machunyu/HC8001/DataSheet/TFT/KD024B_3C/截图1485099521.png

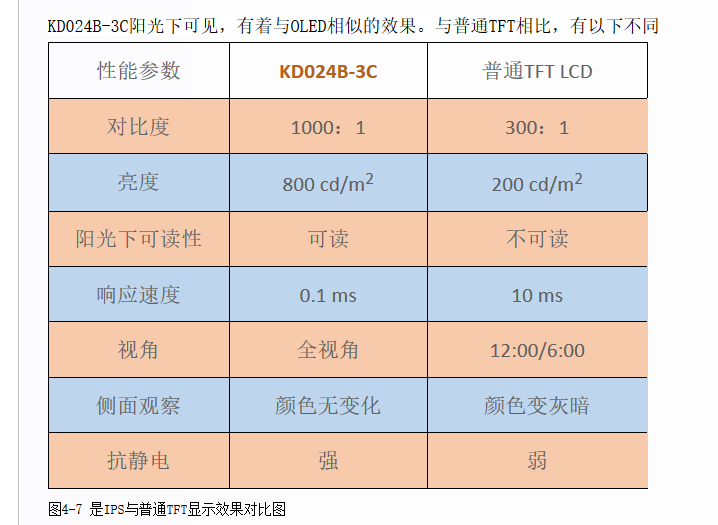
DataSheet/TFT/KD024B_3C/截图1485099521.png
