machunyu/HC8001/Sch/芯片验证板原理图.pdf

5

4

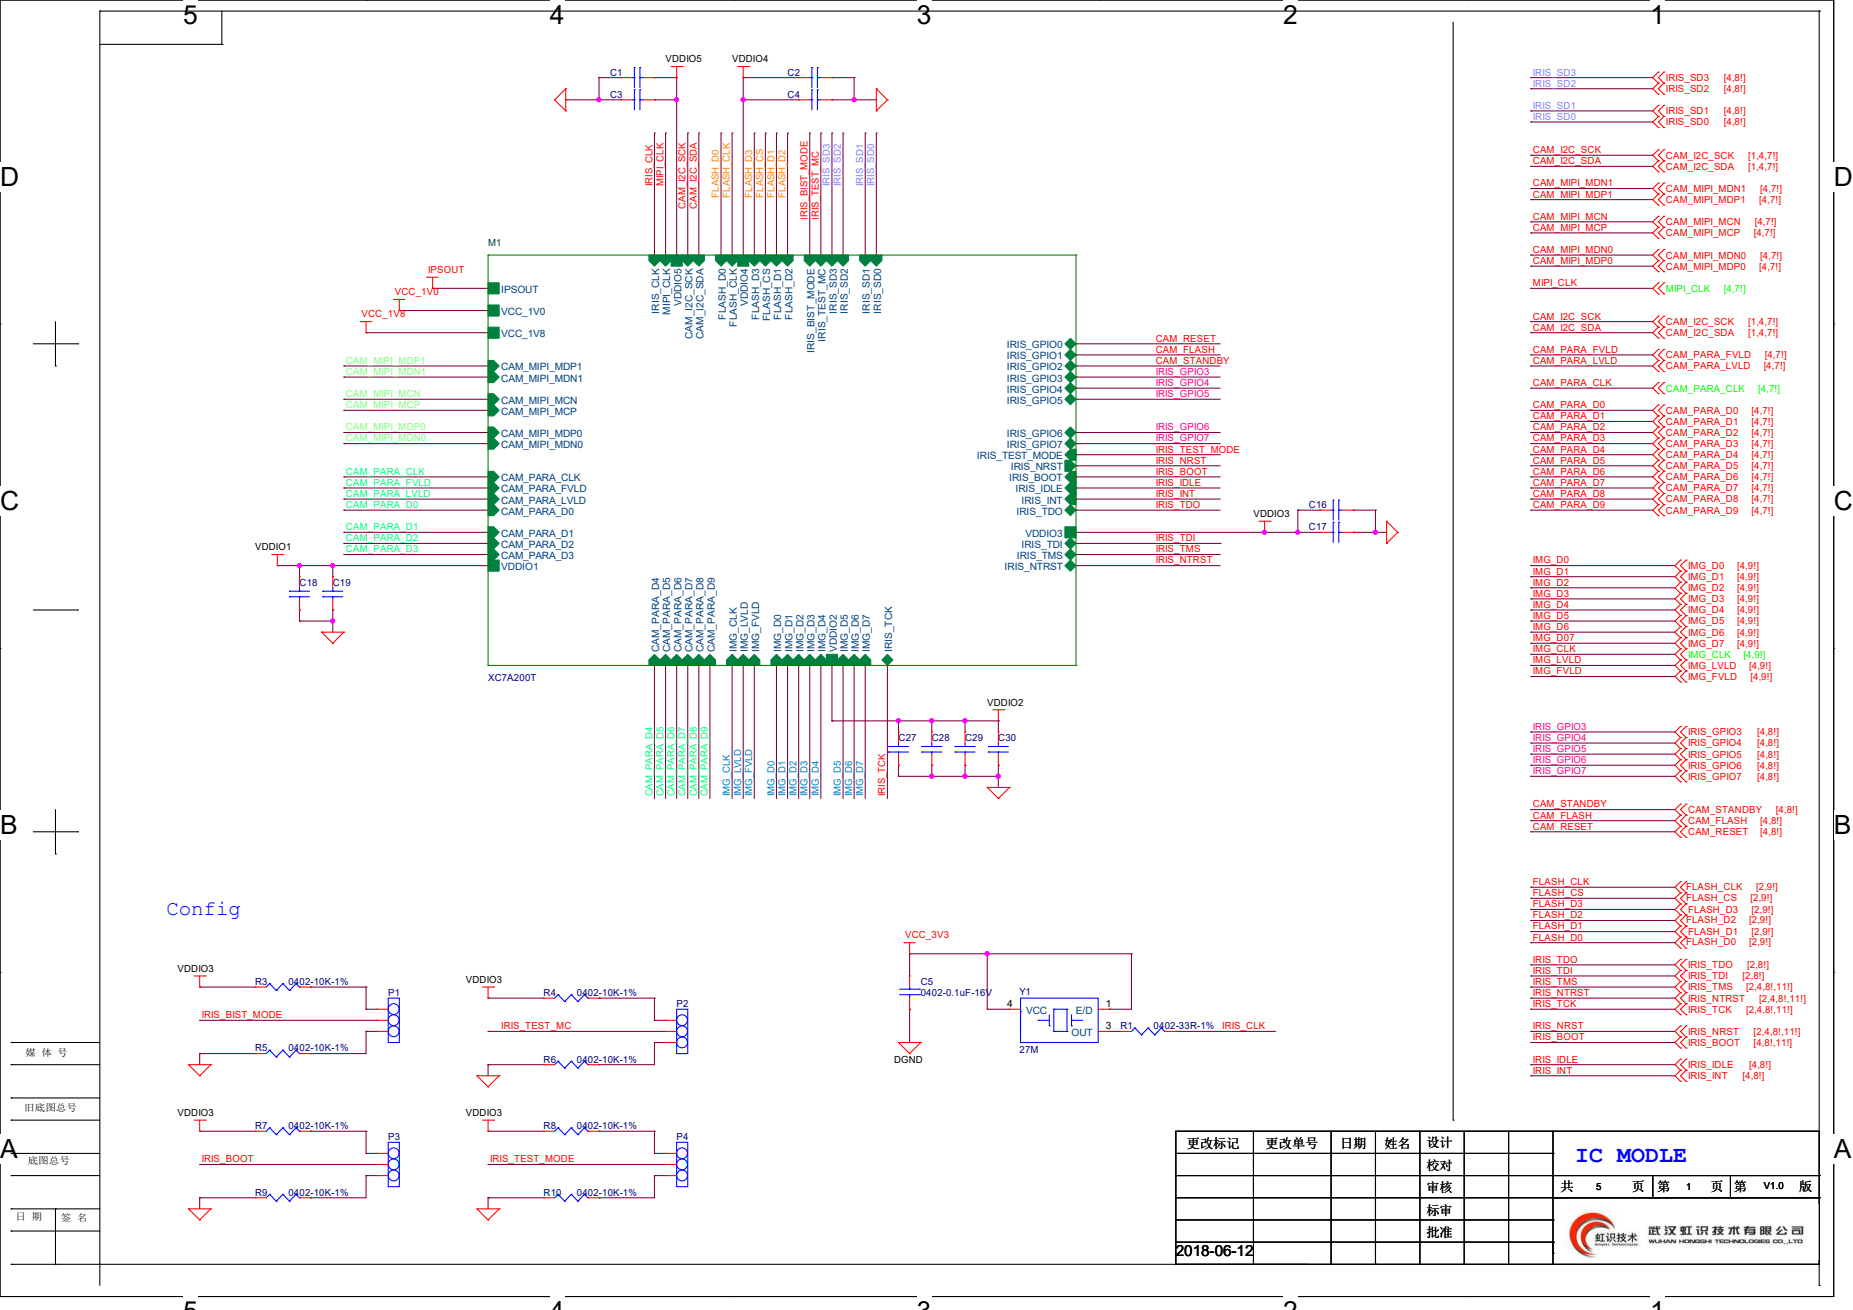
[picture p40: page 1]

D D

# SPI Flash

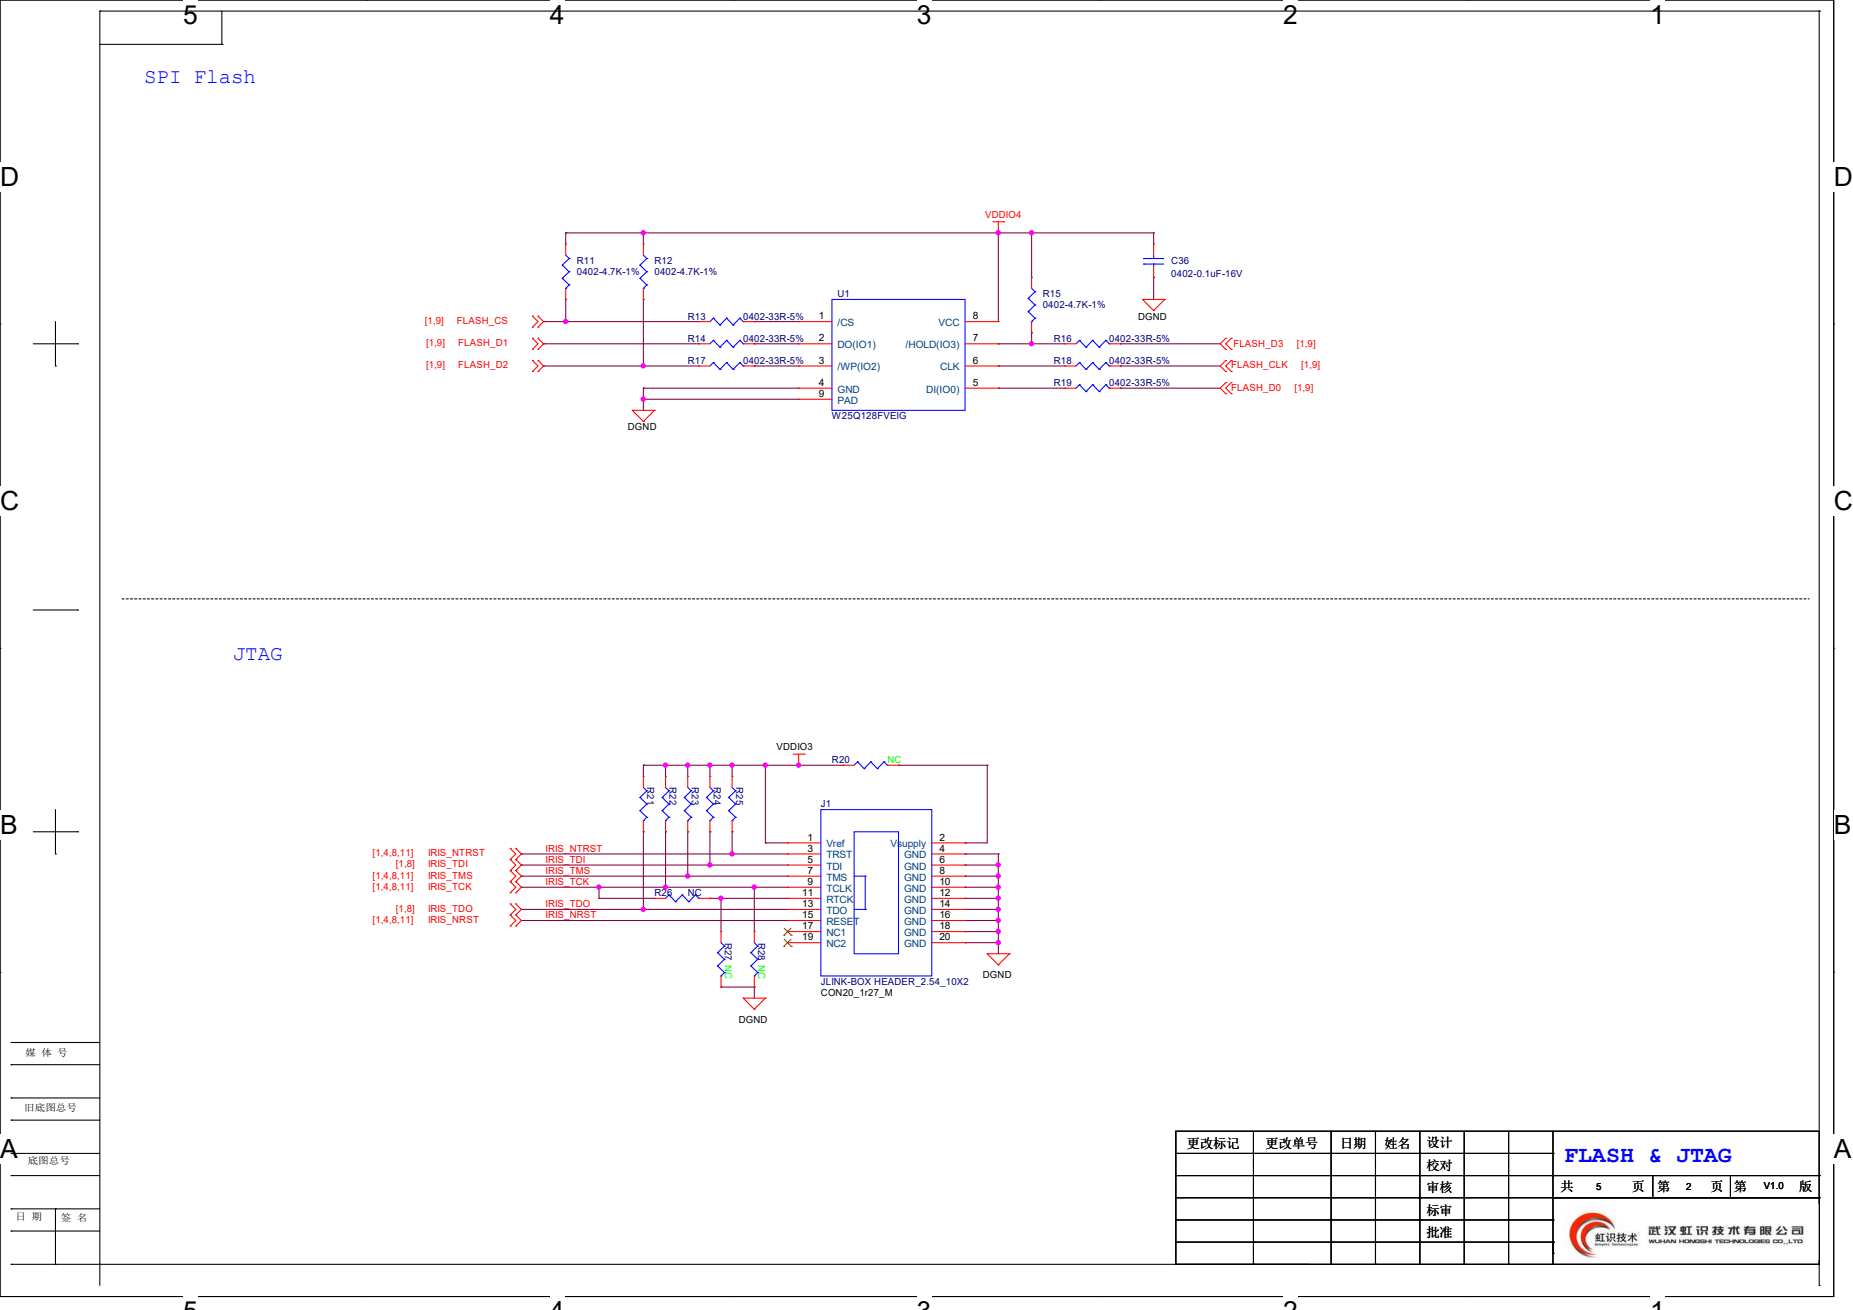
[picture p41: page 2]

D D

3V3

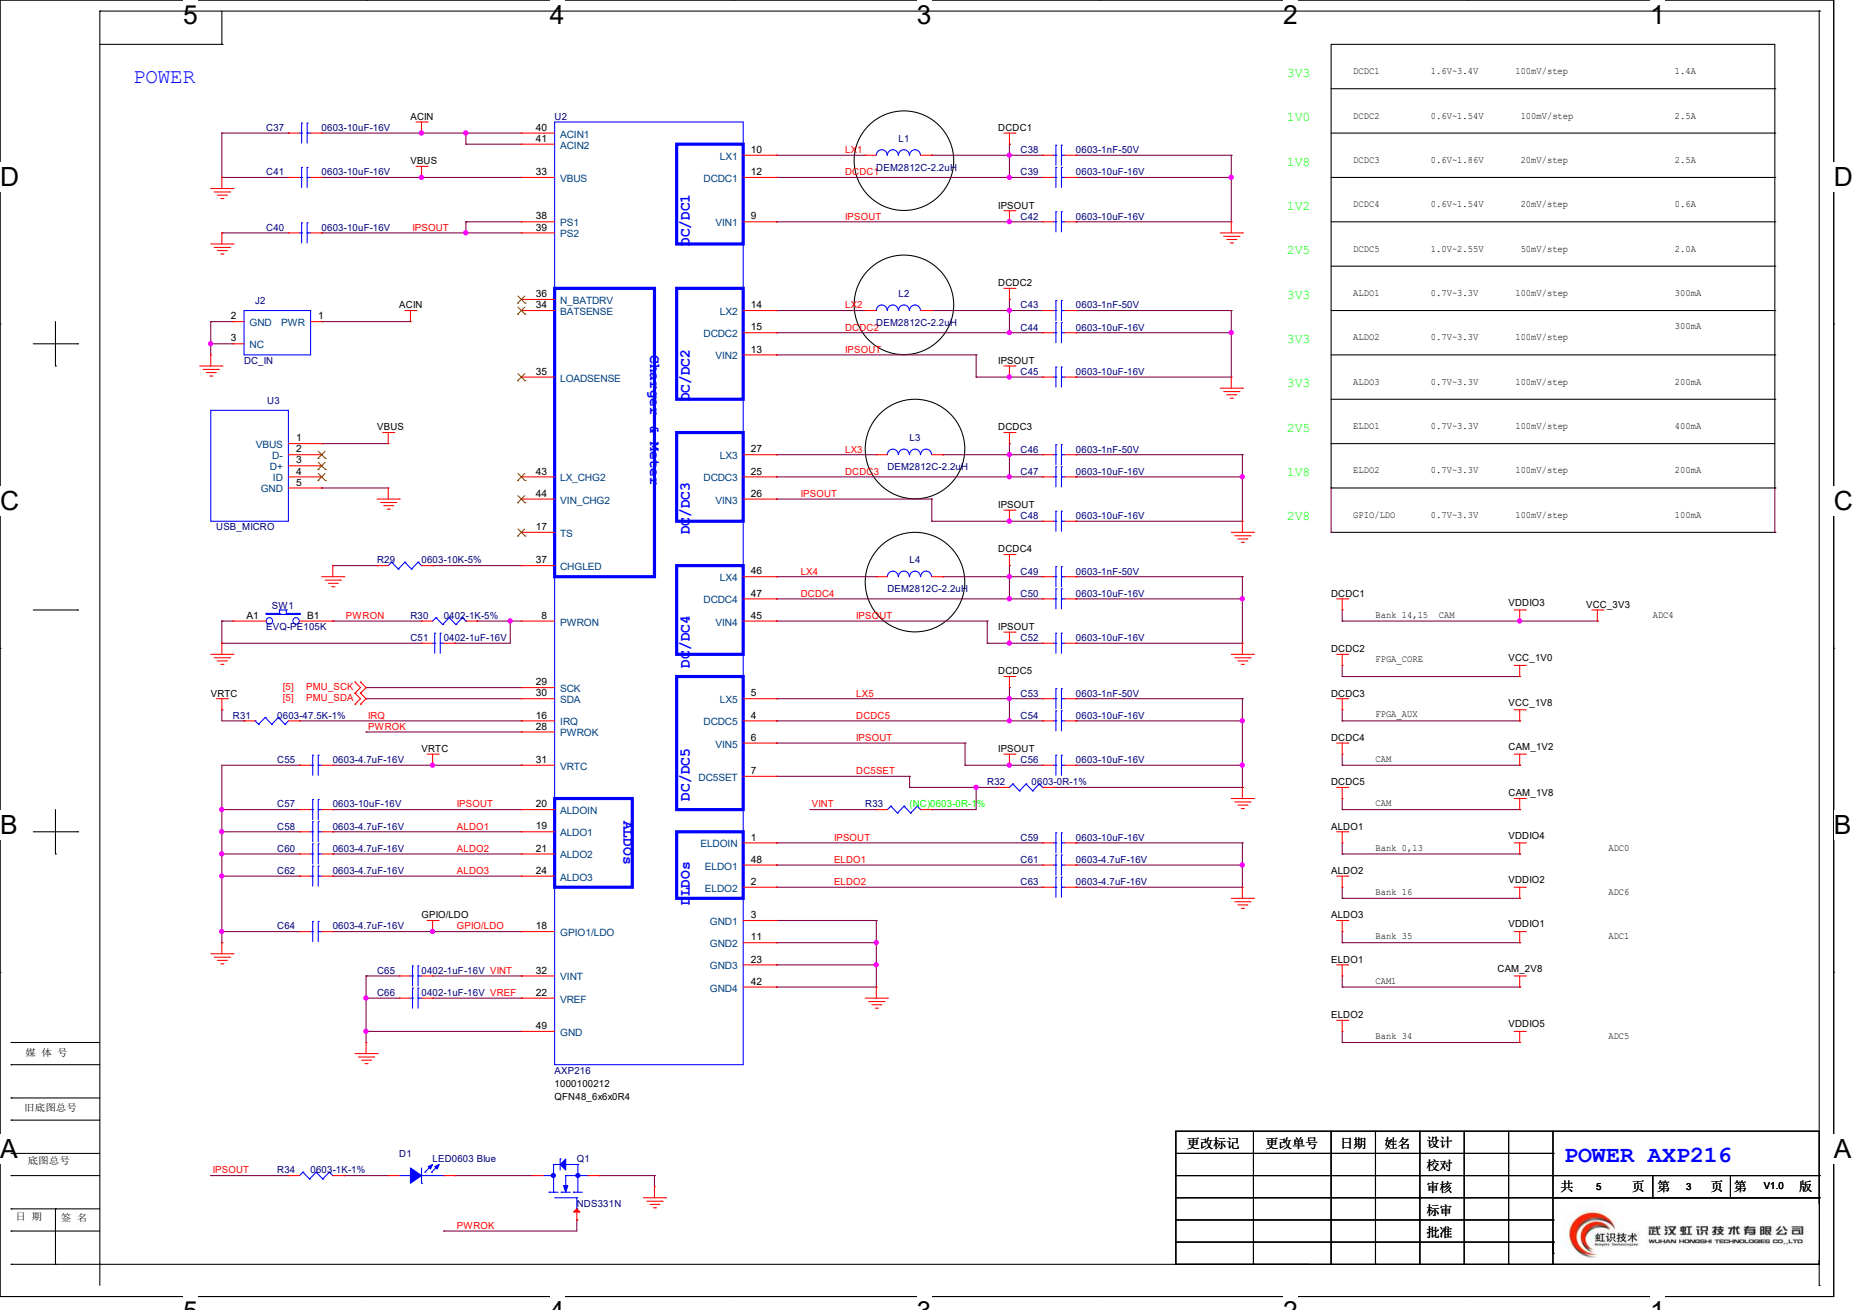
[picture p42: page 3]

L2 DEM2812C-2.2uH
LX3 27 DCDC3 25 PWRON 8 GPIO1/LDO 18 VINT 32 VRTC 31

D D

# CONNECTOR

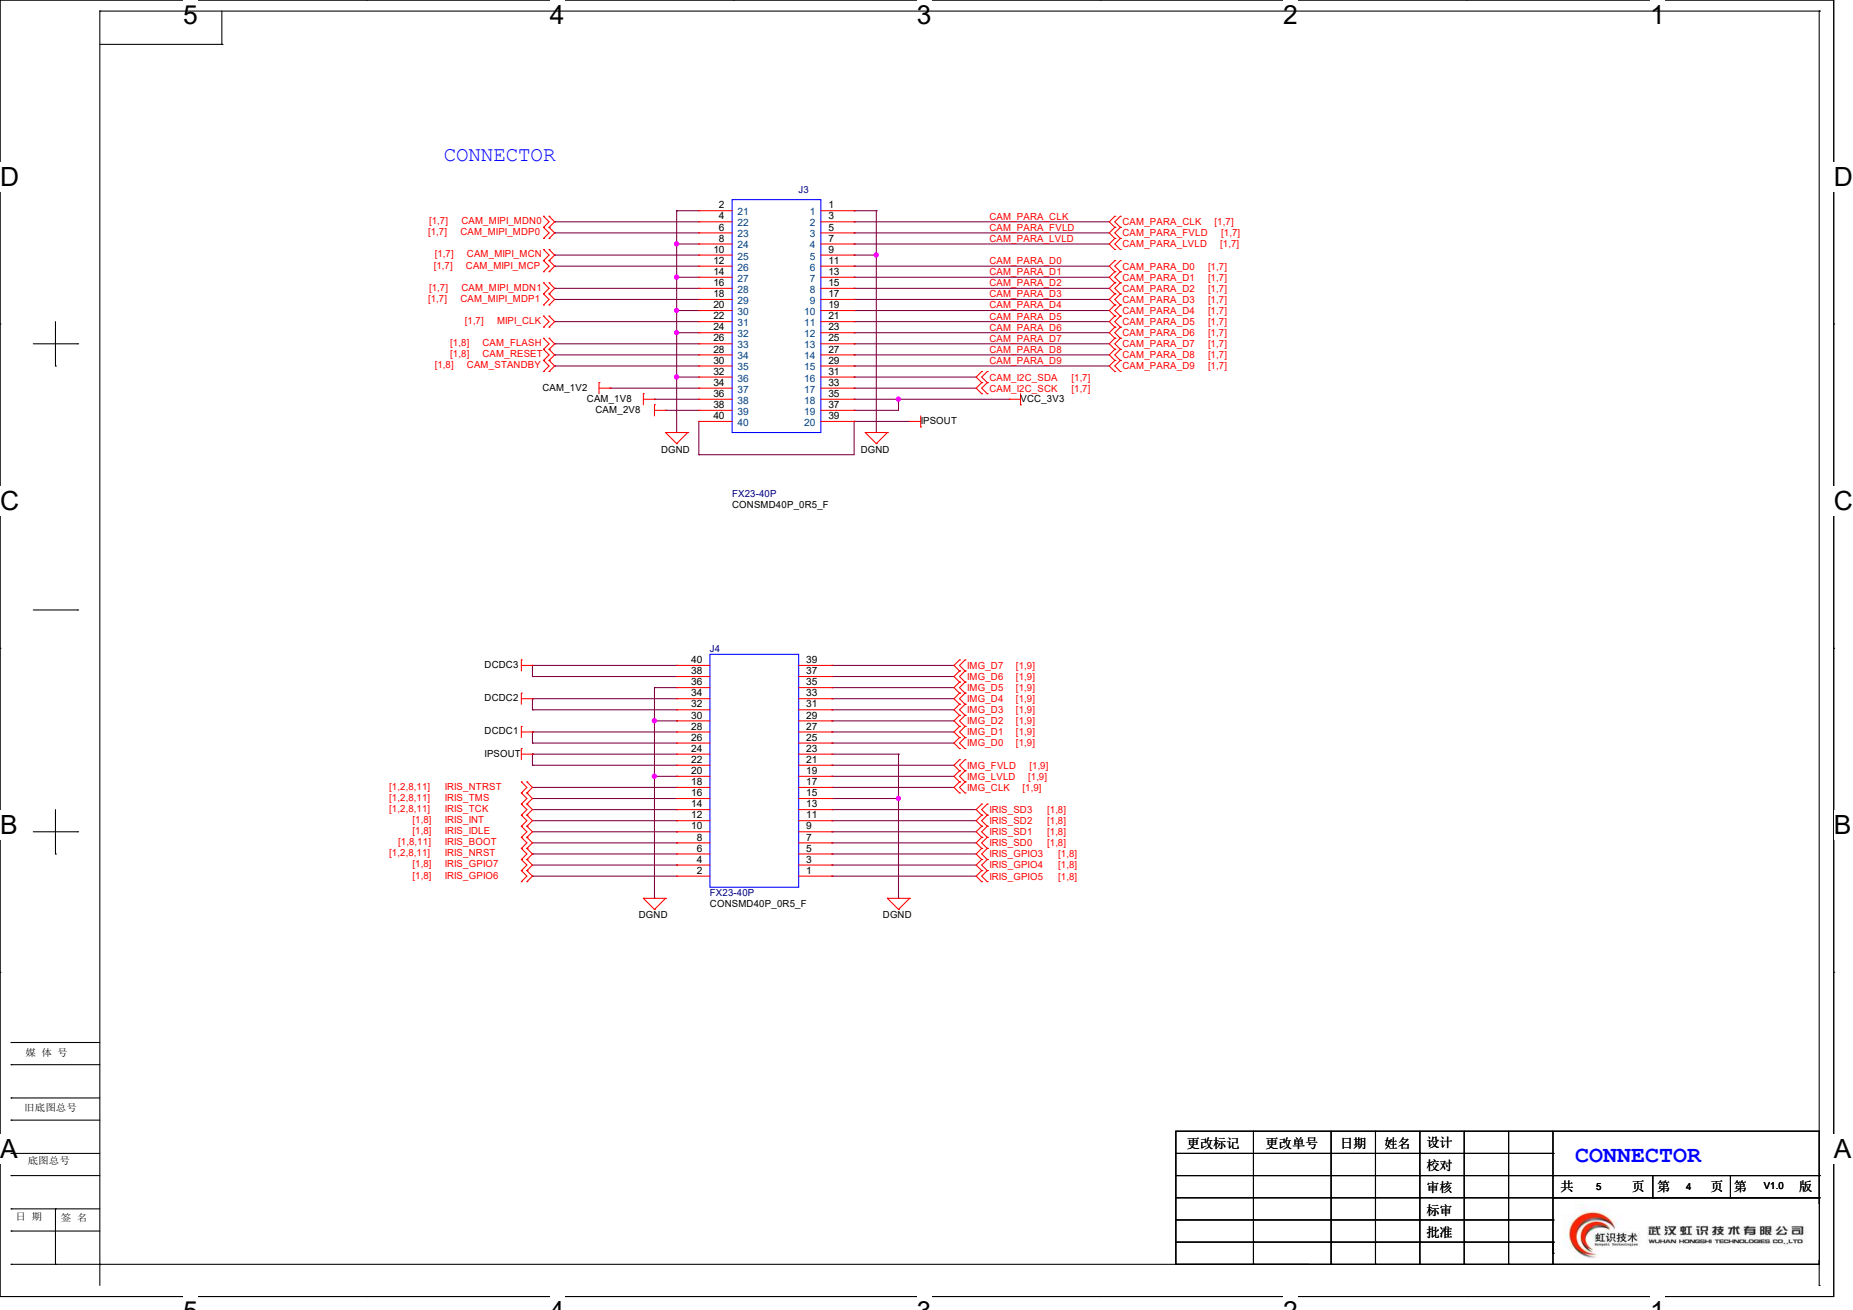
[picture p43: page 4]
底图总号; 旧底图总号; CONNECTOR; CAM_PARA_FVLD CAM_PARA_LVLD; CAM_PARA_D3 CAM_PARA_D4 CAM_PARA_D5 CAM_PARA_D6 CAM_PARA_D7 CAM_PARA_D8 CAM_PARA_D9 CAM_PARA_D1 CAM_PARA_D2 CAM_PARA_D0 CAM_PARA_CLK; DCDC3 DCDC2 DCDC1; IPSOUT; DGND; VCC_3V3 CAM_1V2CAM_1V8 CAM_2V8; CAM_PARA_D3; [1,7] CAM_PARA_D4; [1,7] CAM_PARA_D5; [1,7] CAM_PARA_D6; [1,7] CAM_PARA_D7; [1,7] CAM_PARA_D8; [1,7] CAM_PARA_D9; [1,7] CAM_PARA_LVLD; [1,7] CAM_PARA_FVLD; CAM_STANDBY; CAM_MIPI_MDN1; CAM_MIPI_MDP1; CAM_MIPI_MCP; CAM_MIPI_MCN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

D D

# MCU_LED1 MCU_LED2 MCU_LED3 ADC5 ADC6

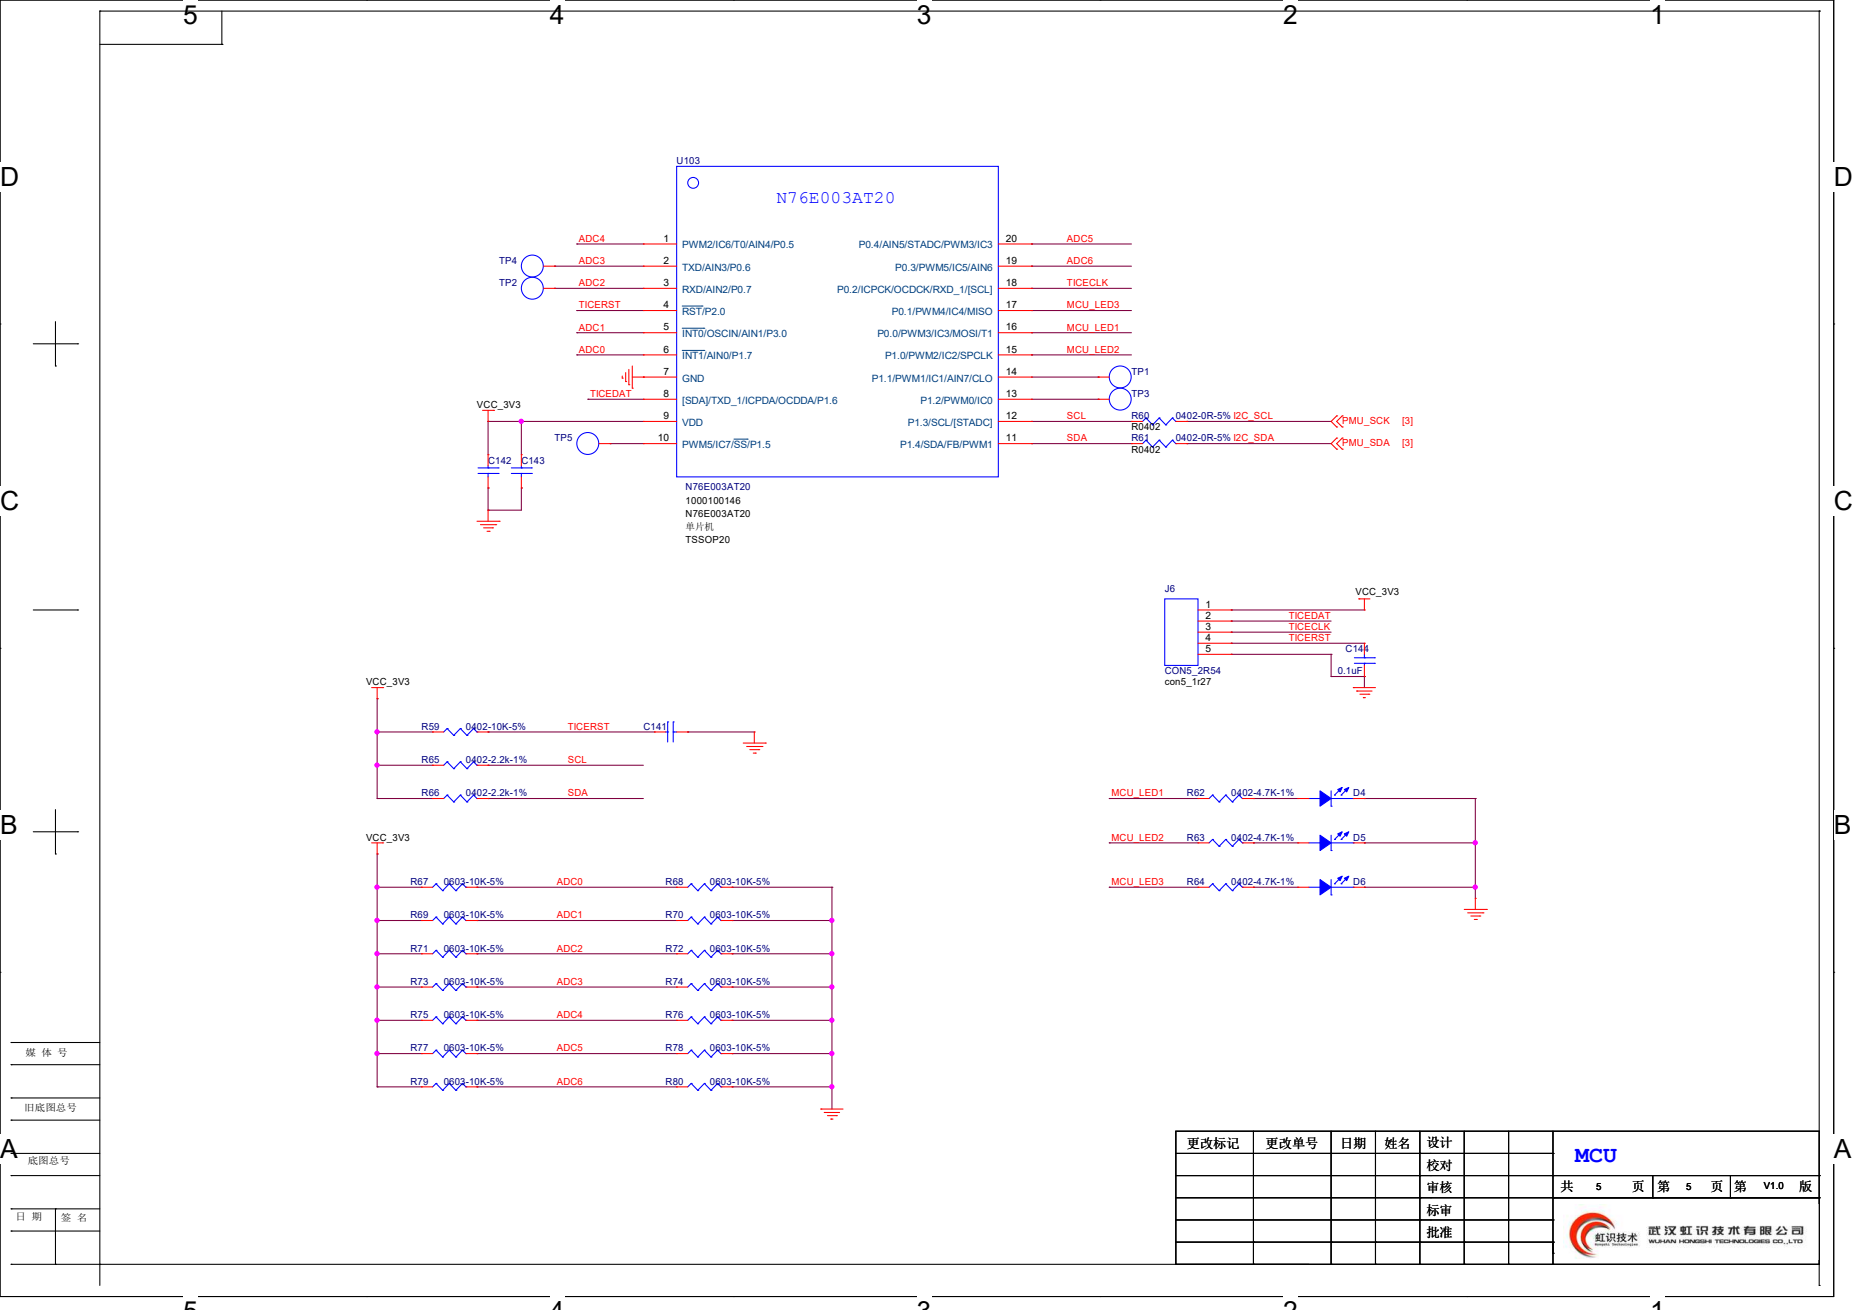
[picture p44: page 5]

D D

# JTAG Connecter

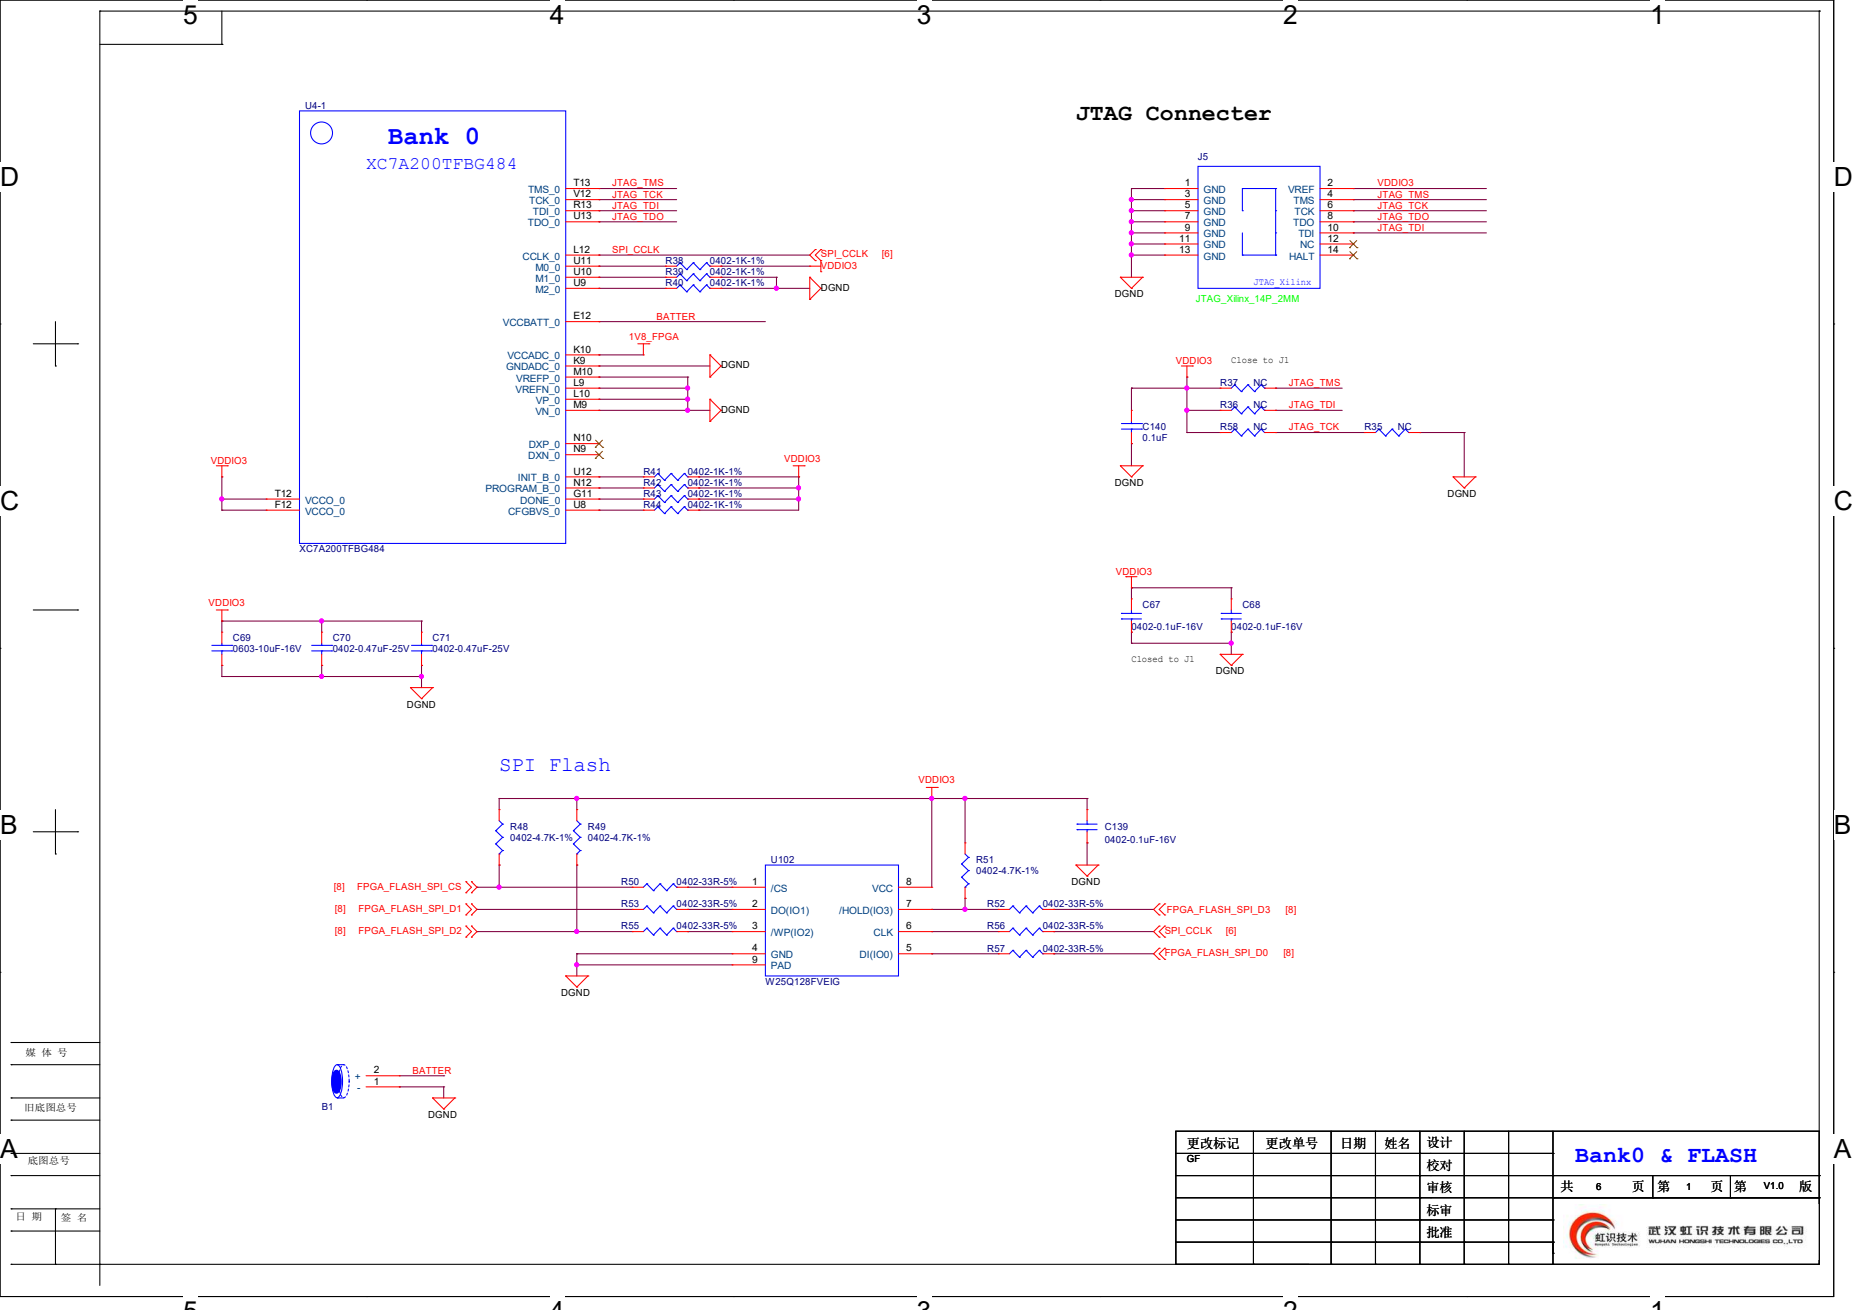
[picture p45: page 6]

D D

# Bank 35

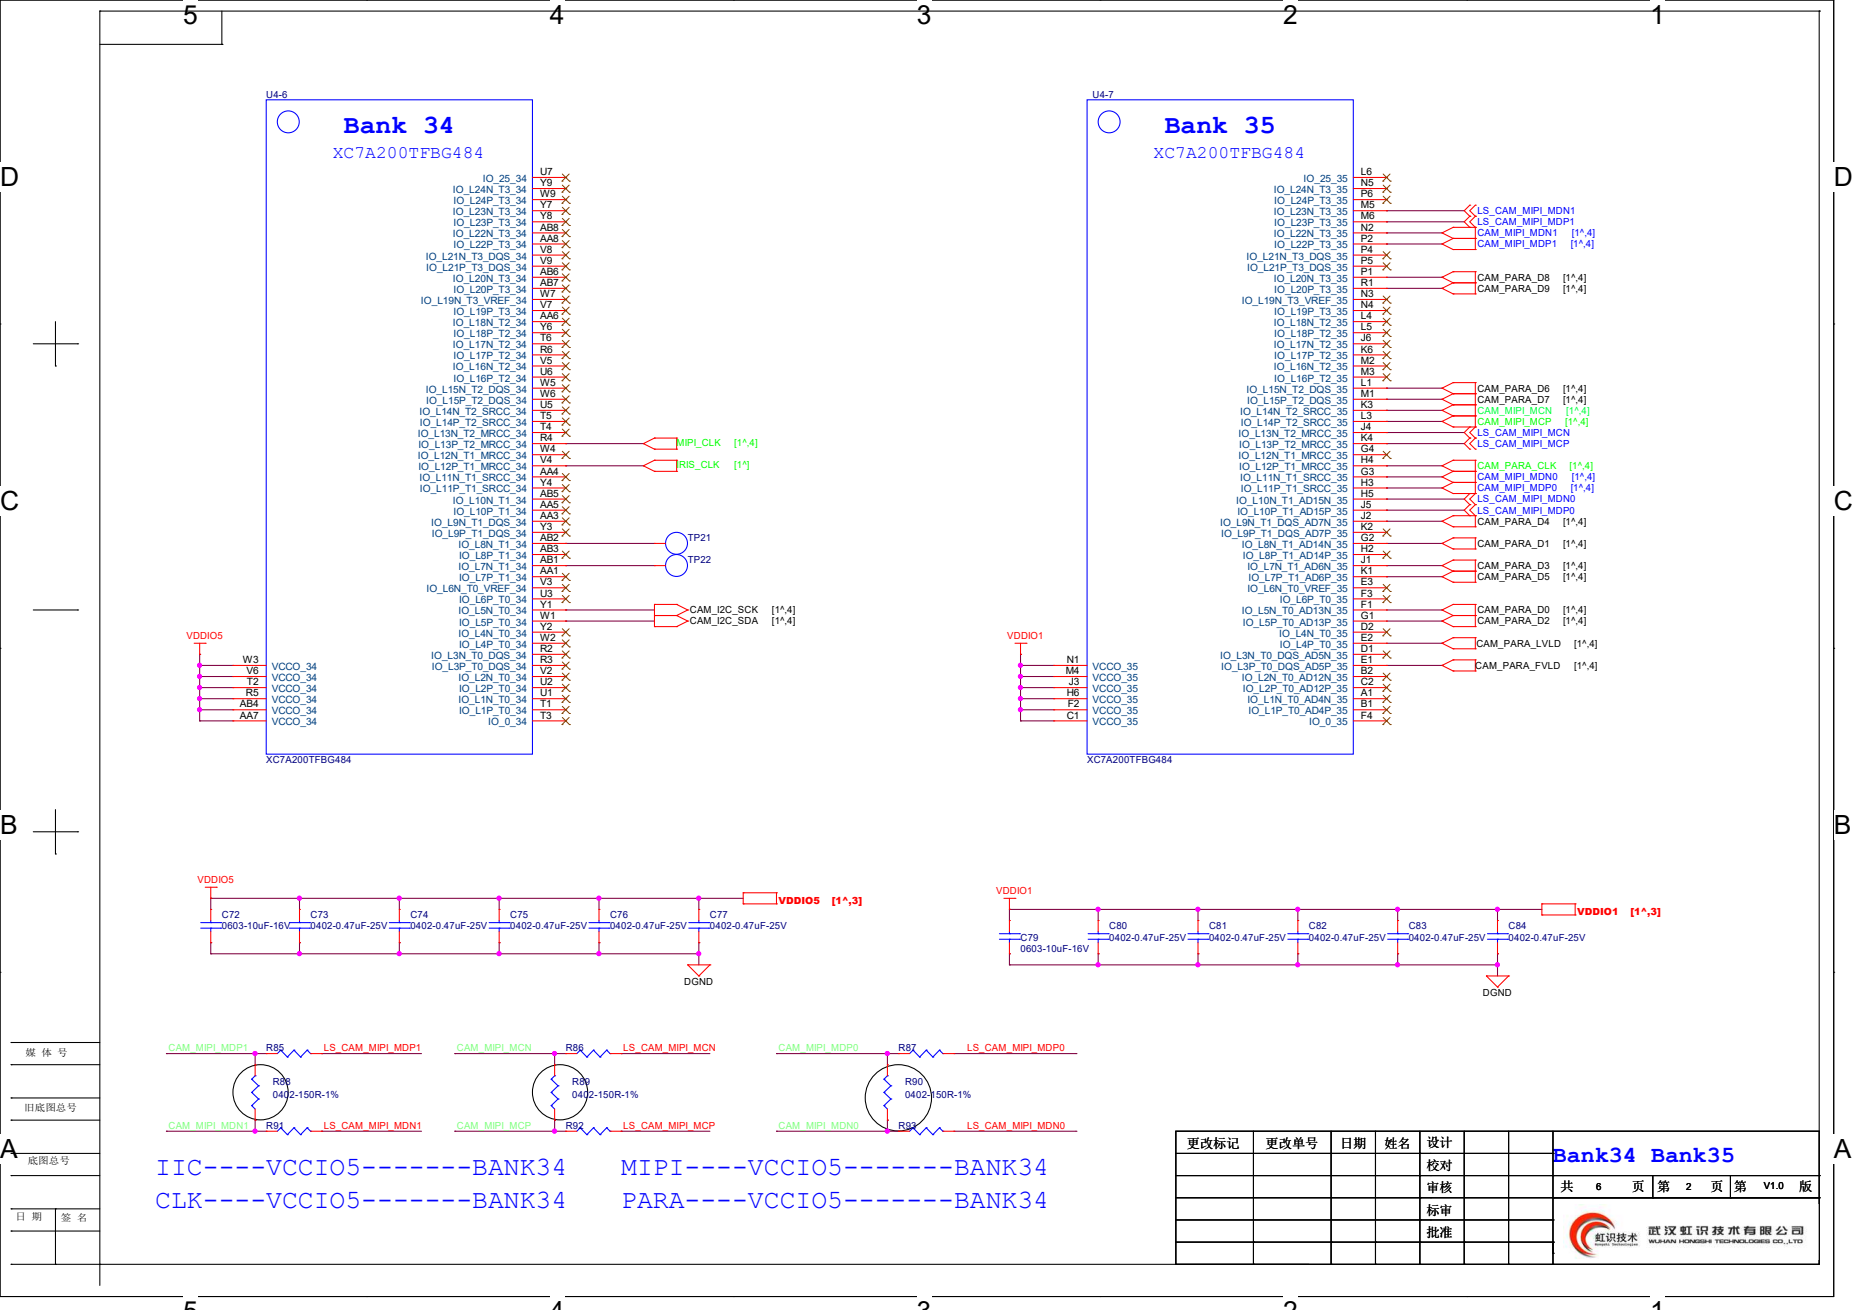
[picture p46: page 7]

D D

# LED3 [8] LED4 [8]

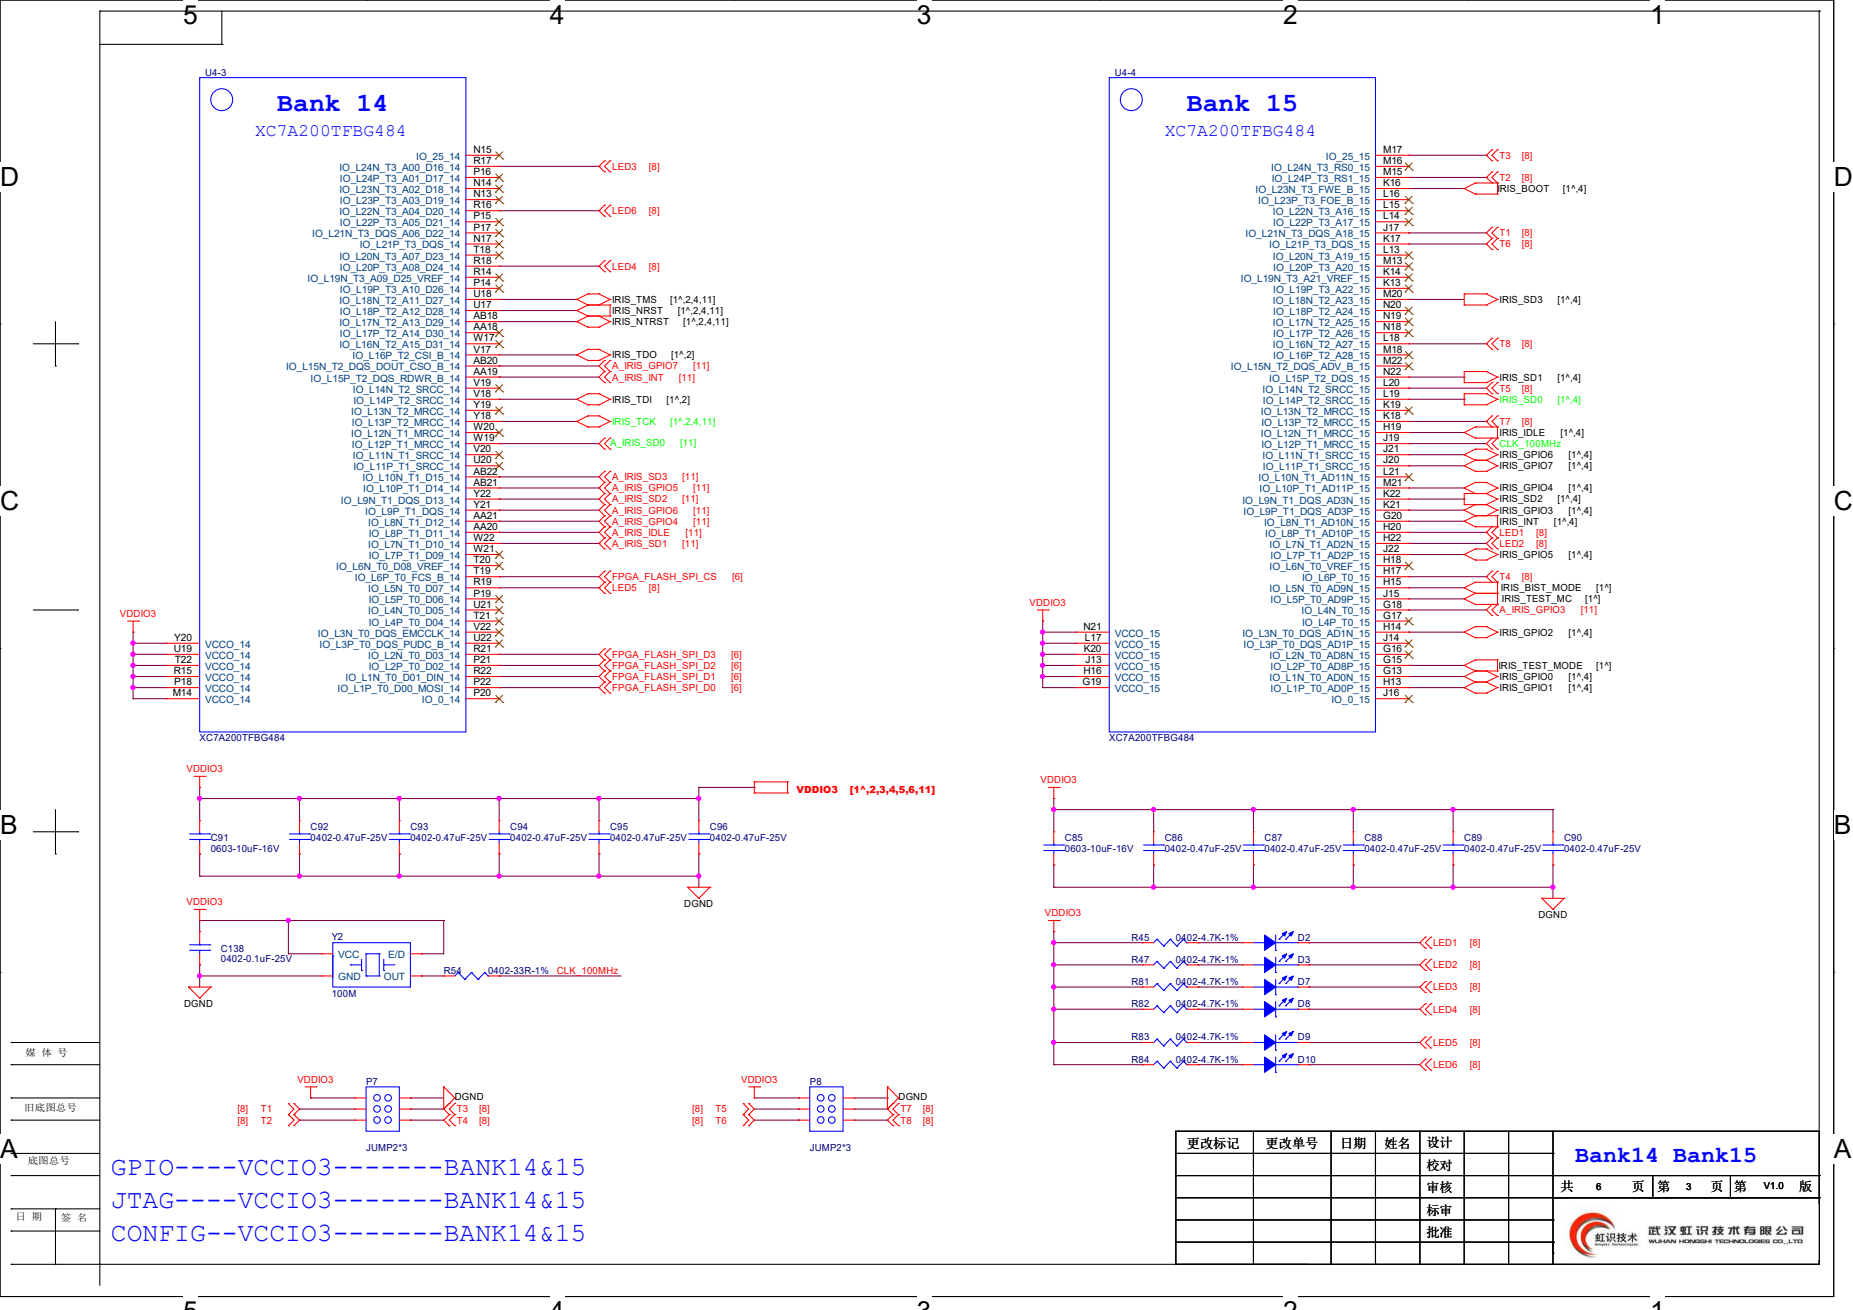
[picture p47: page 8]

D D

# Bank 13

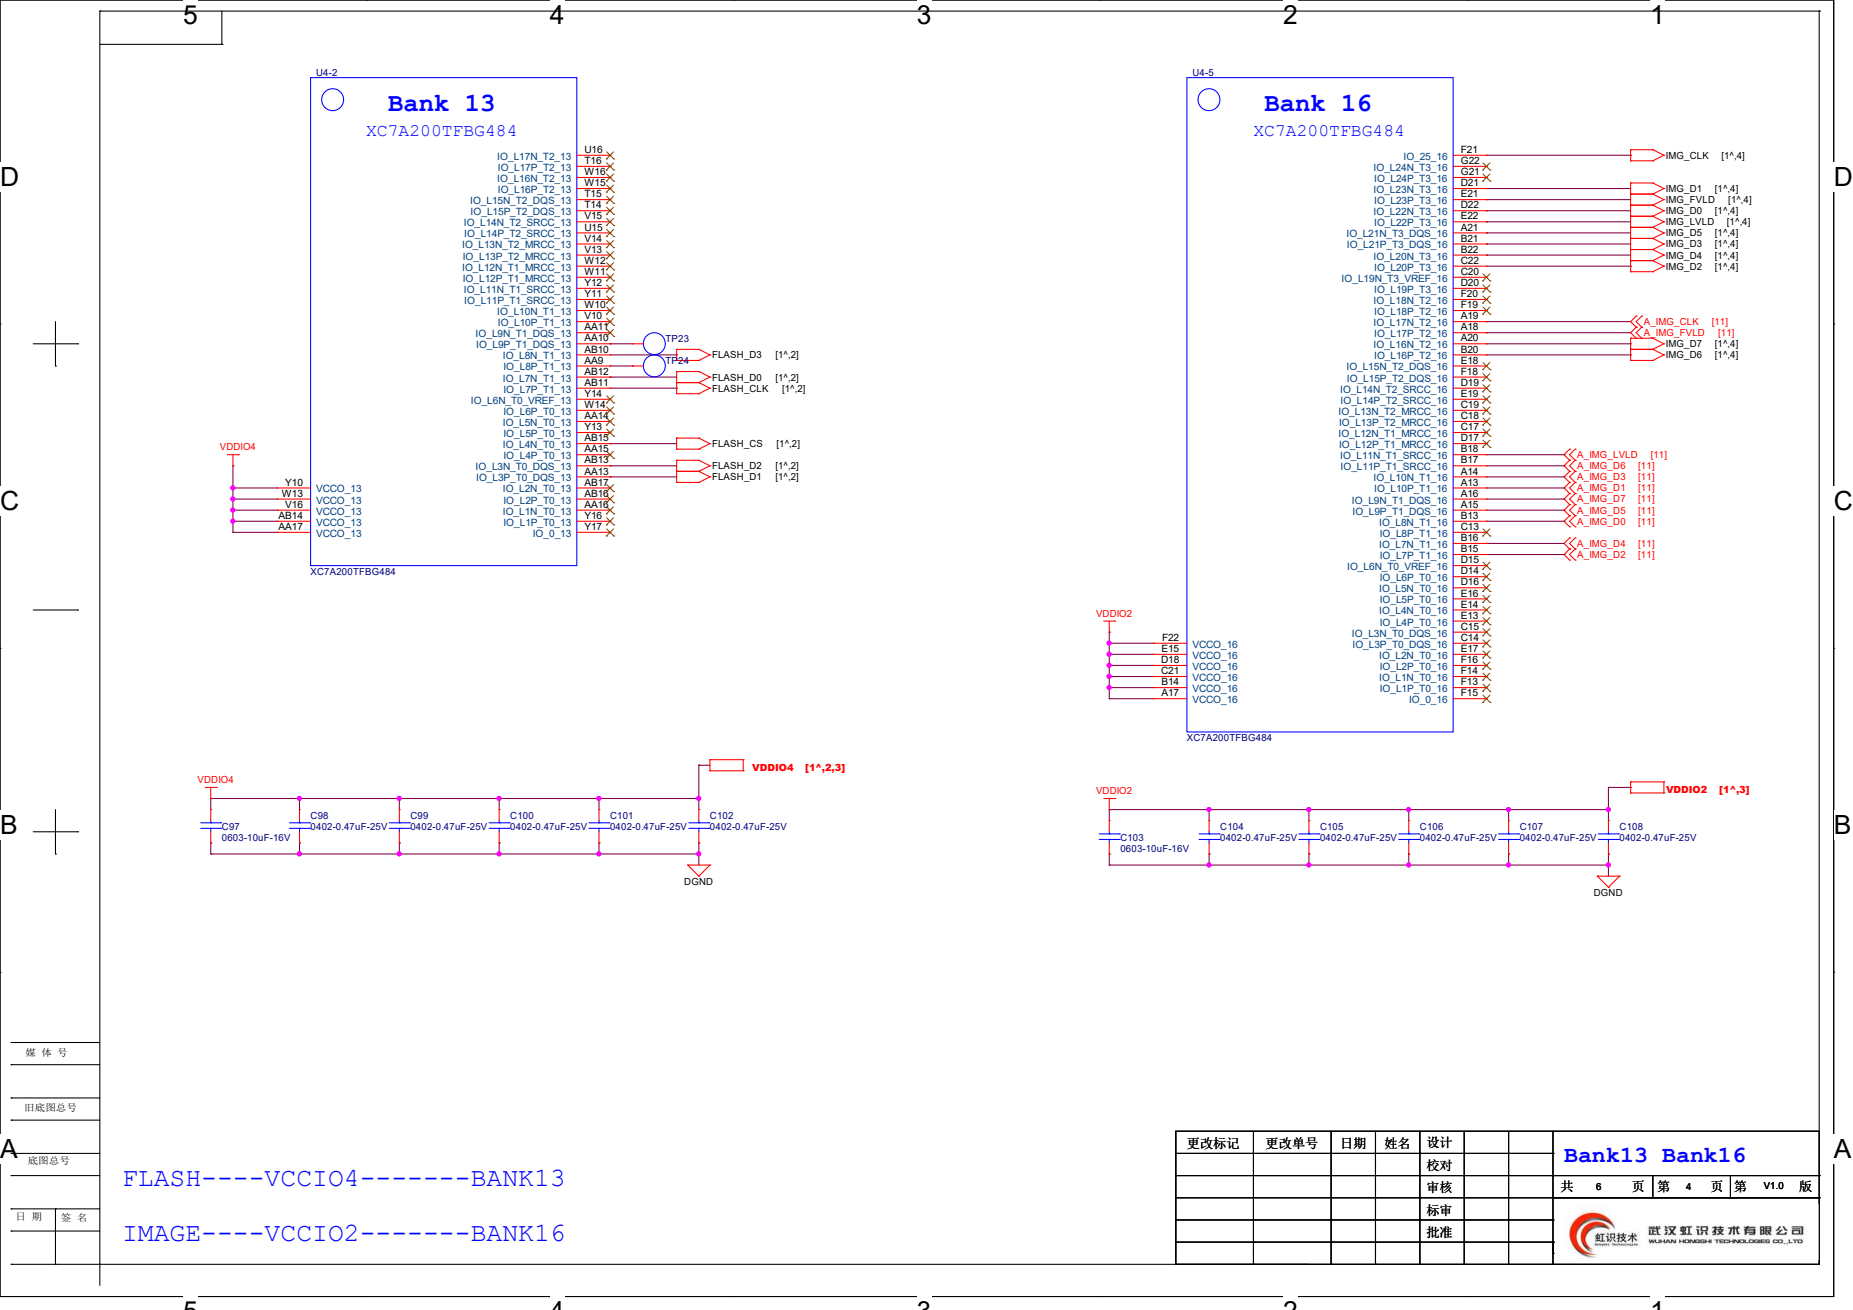
[picture p48: page 9]

D D

# Power GND

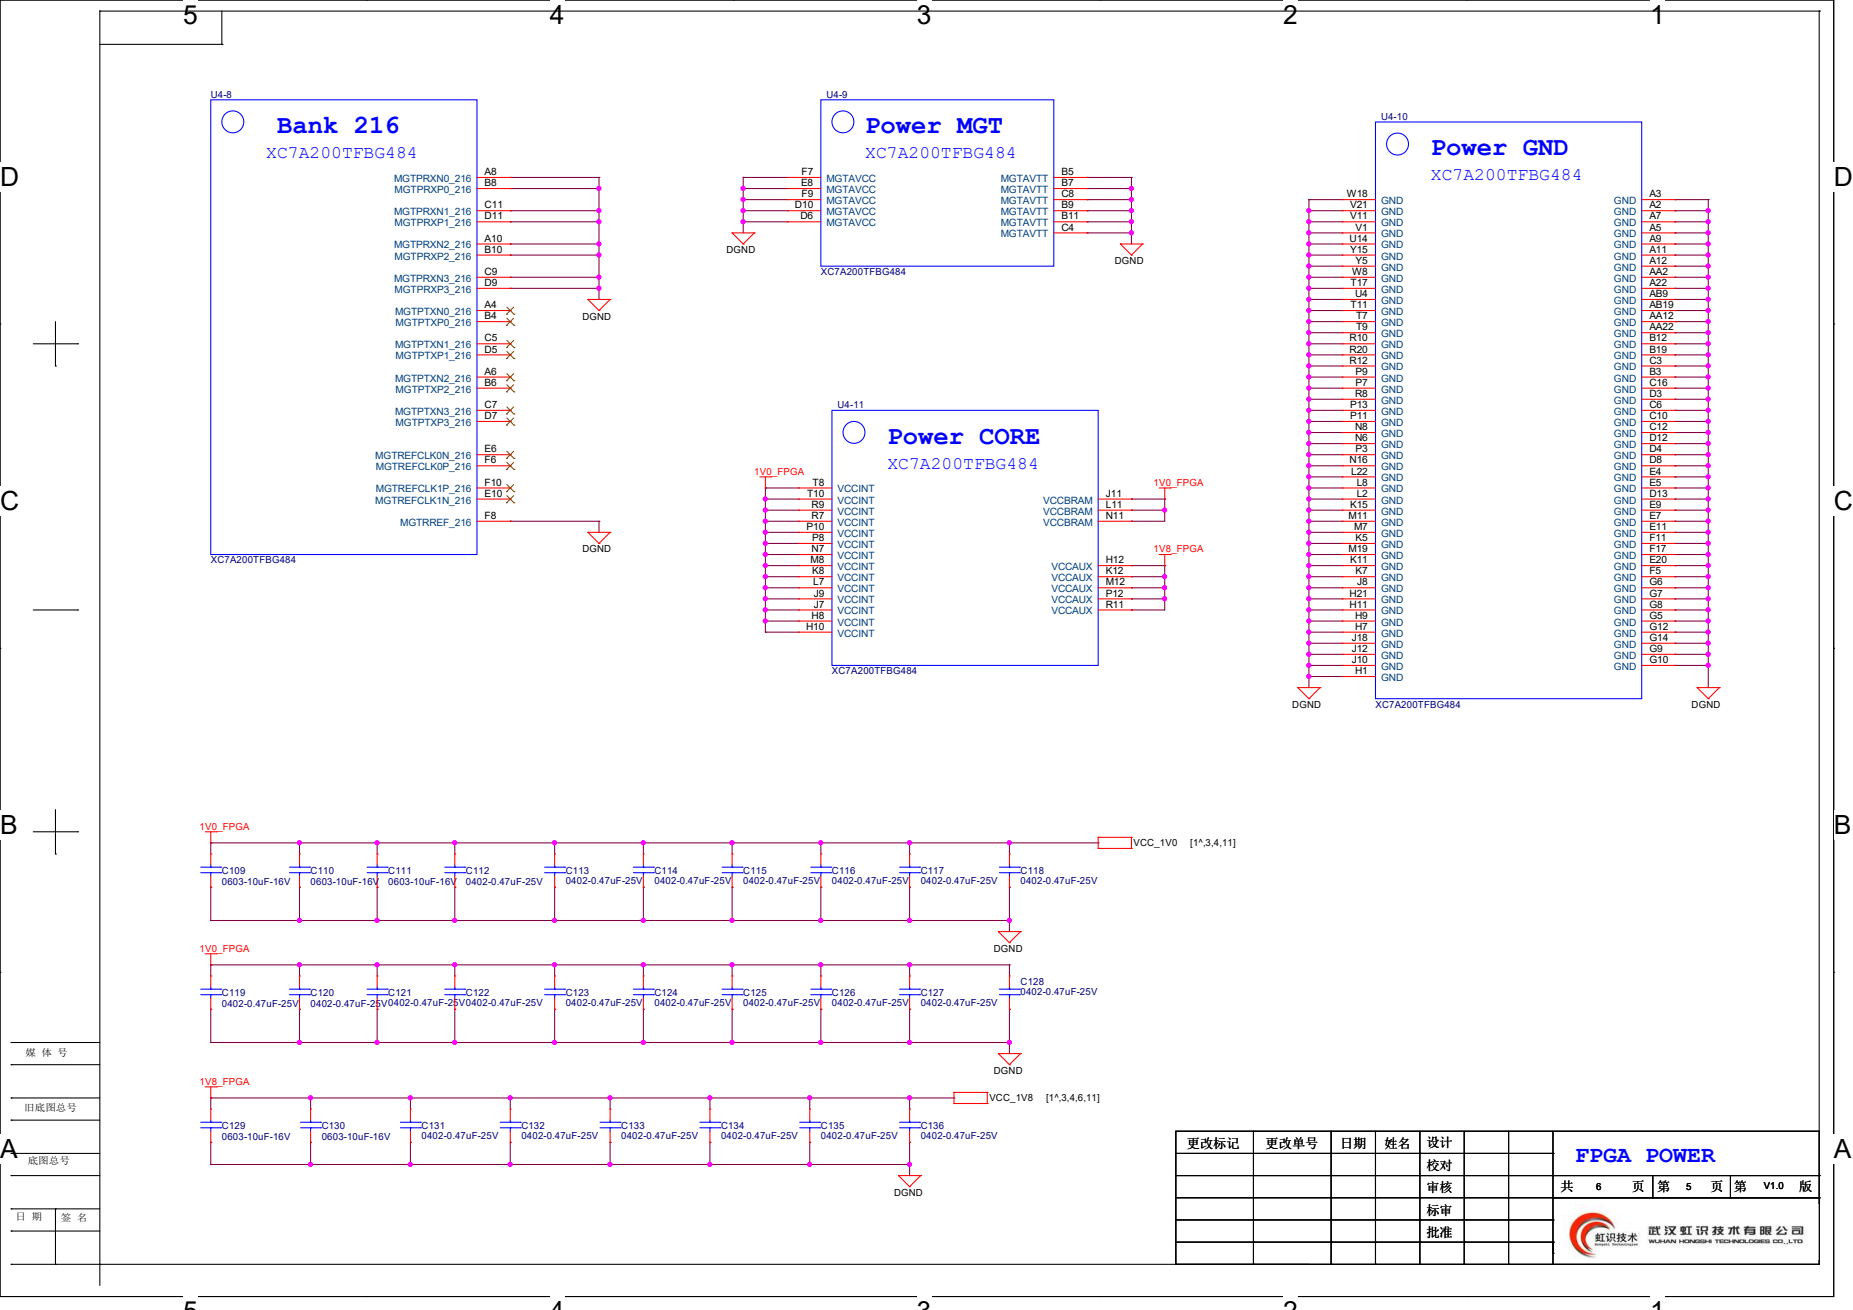
[picture p49: page 10]

D D

## MIPI

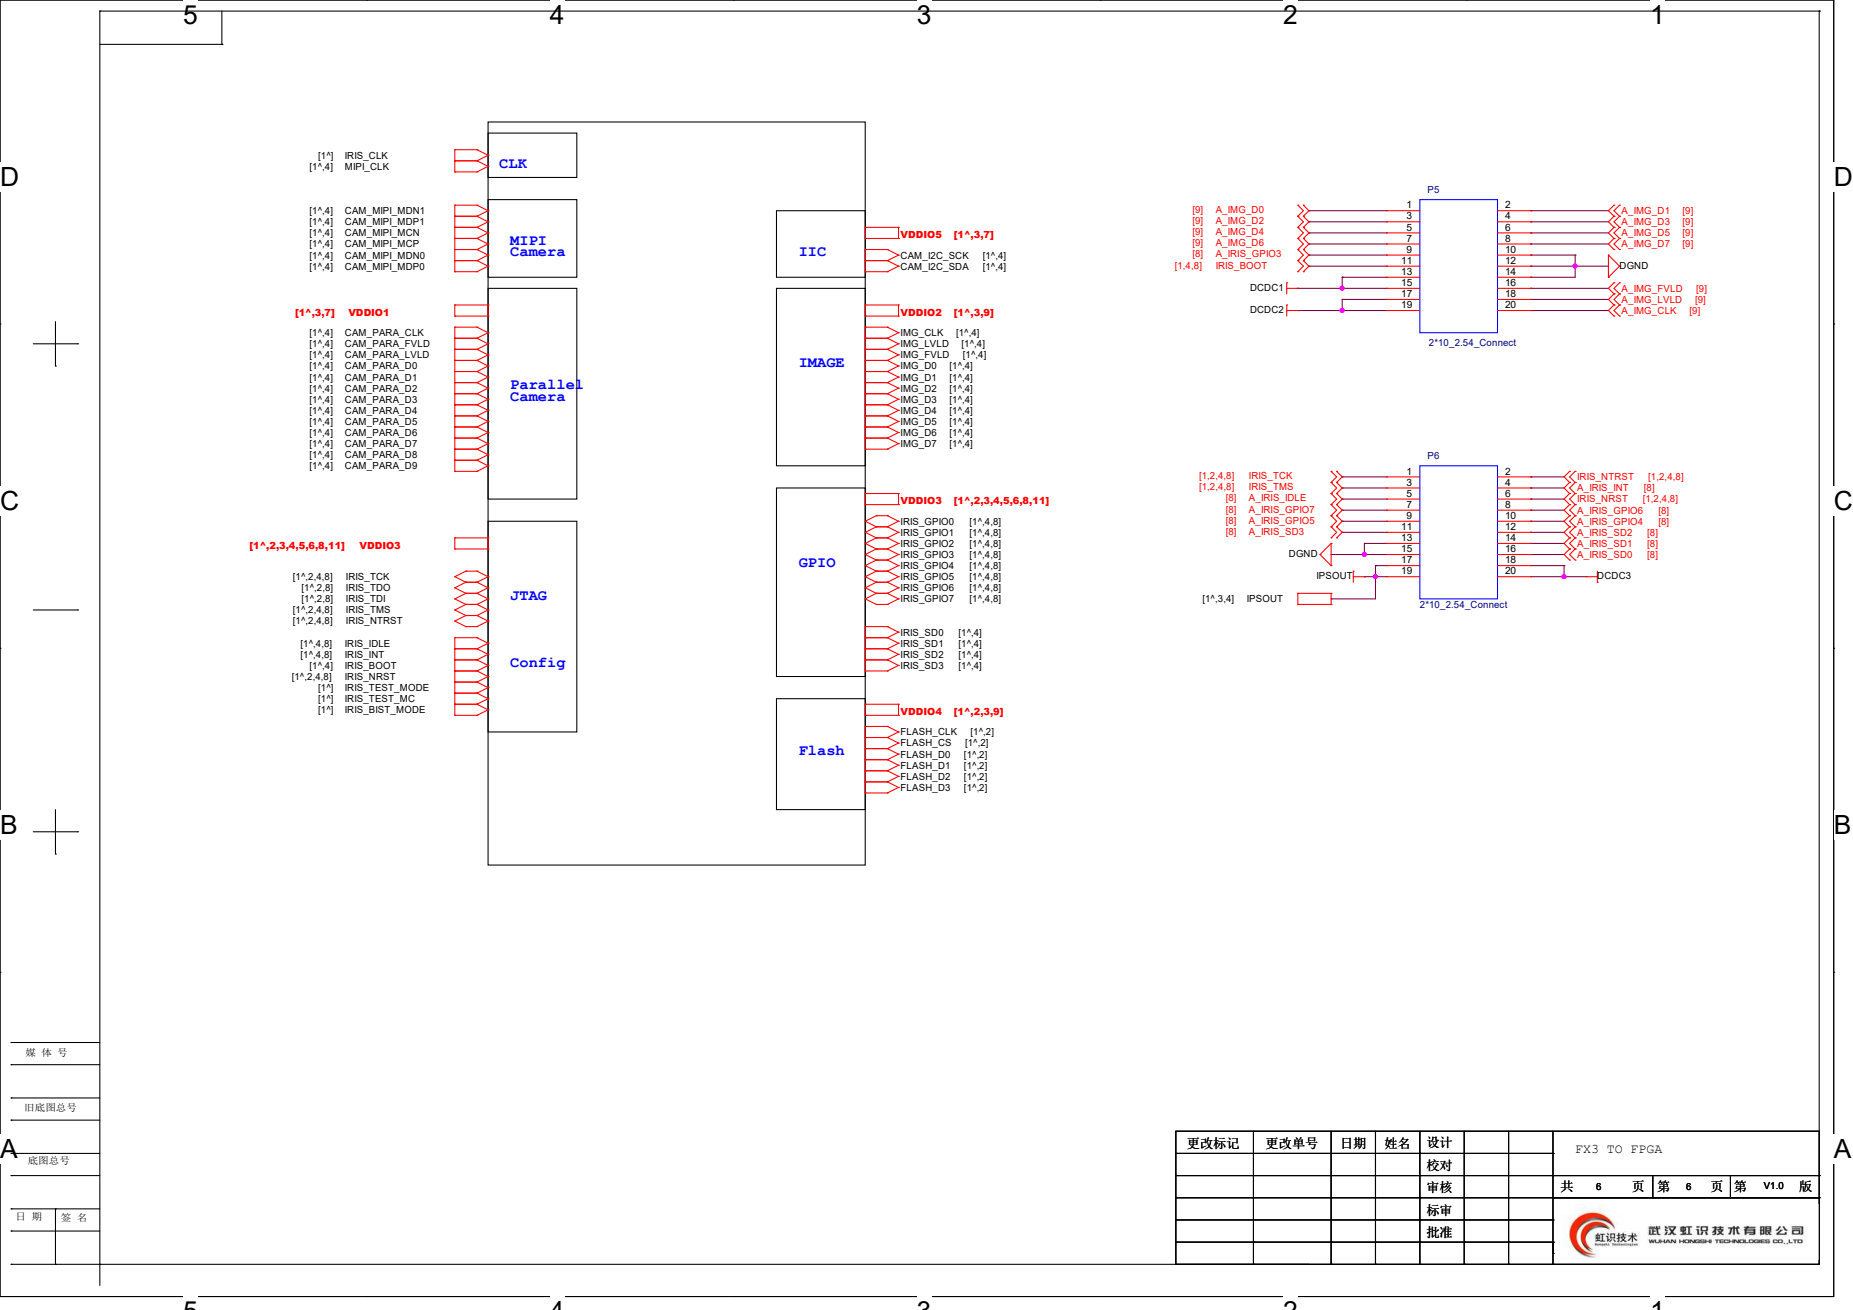
[picture p50: page 11]
底图总号; 旧底图总号; FX3 TO FPGA; Parallel; Camera; JTAG; Config; Flash; GPIO; IMAGE; IIC; CLK; [1^,4] CAM_PARA_CLK [1^,4] CAM_PARA_FVLD [1^,4] CAM_PARA_LVLD [1^,4] CAM_PARA_D0 [1^,4] CAM_PARA_D1 [1^,4] CAM_PARA_D2 [1^,4] CAM_PARA_D3 [1^,4] CAM_PARA_D4 [1^,4] CAM_PARA_D5 [1^,4] CAM_PARA_D6 [1^,4] CAM_PARA_D7 [1^,4] CAM_PARA_D8 [1^,4] CAM_PARA_D9; IMG_CLK [1^,4] IMG_LVLD [1^,4]; IMG_FVLD; IMG_D0 [1^,4] IMG_D1 [1^,4] IMG_D2 [1^,4] IMG_D3 [1^,4] IMG_D4 [1^,4] IMG_D5 [1^,4] IMG_D6 [1^,4] IMG_D7 [1^,4]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
