machunyu/HC8001/Sch/HS-T-0073A.pdf

D | D

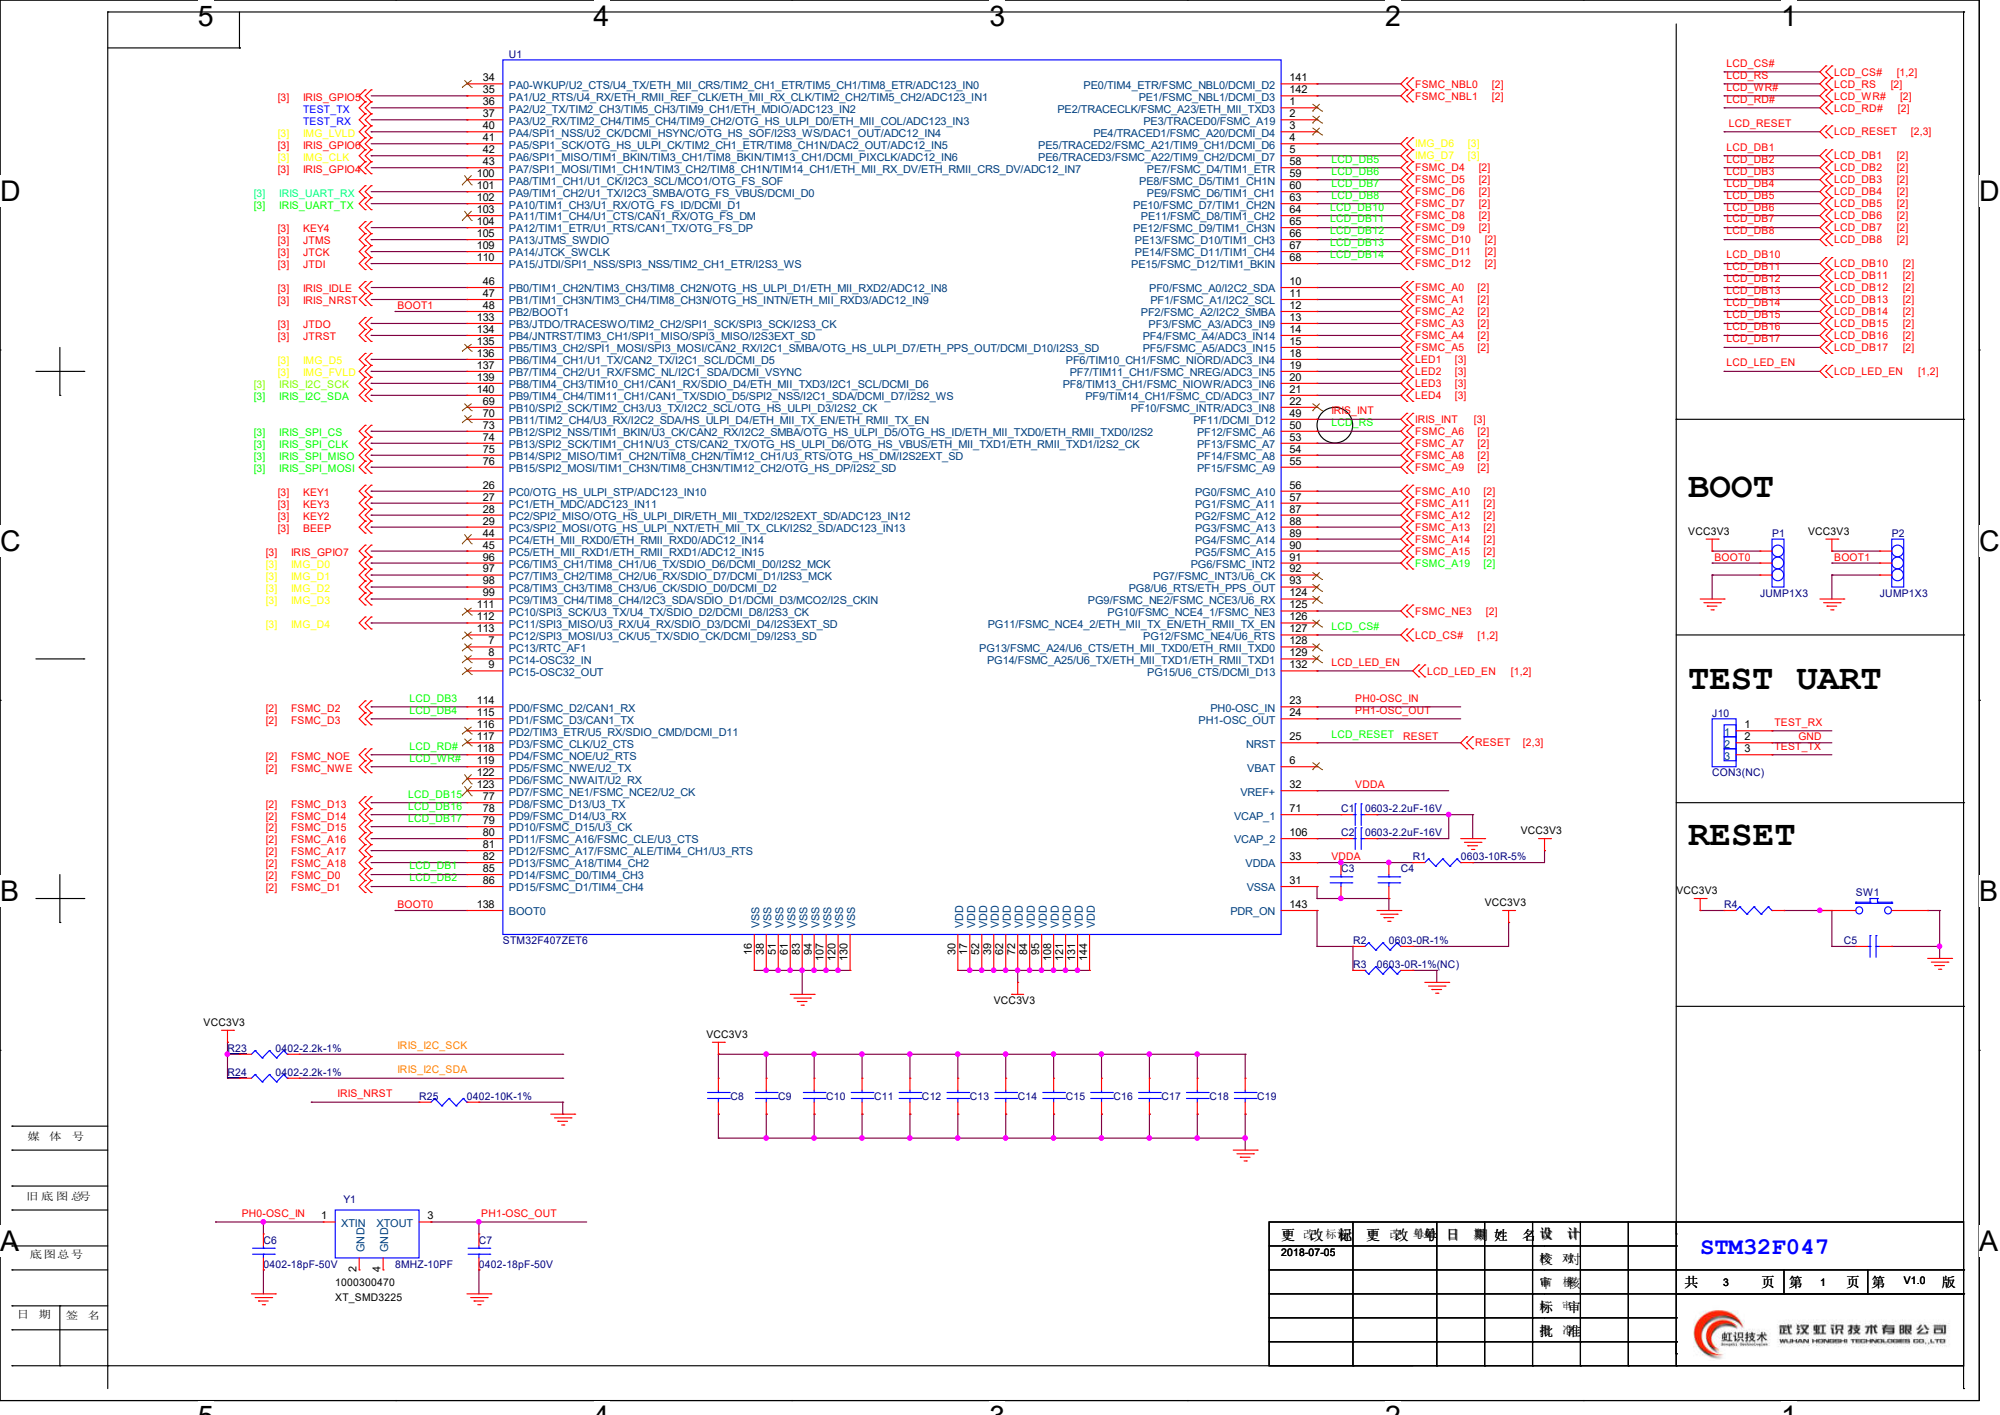
[picture p51: page 1]

D | D

## LCD

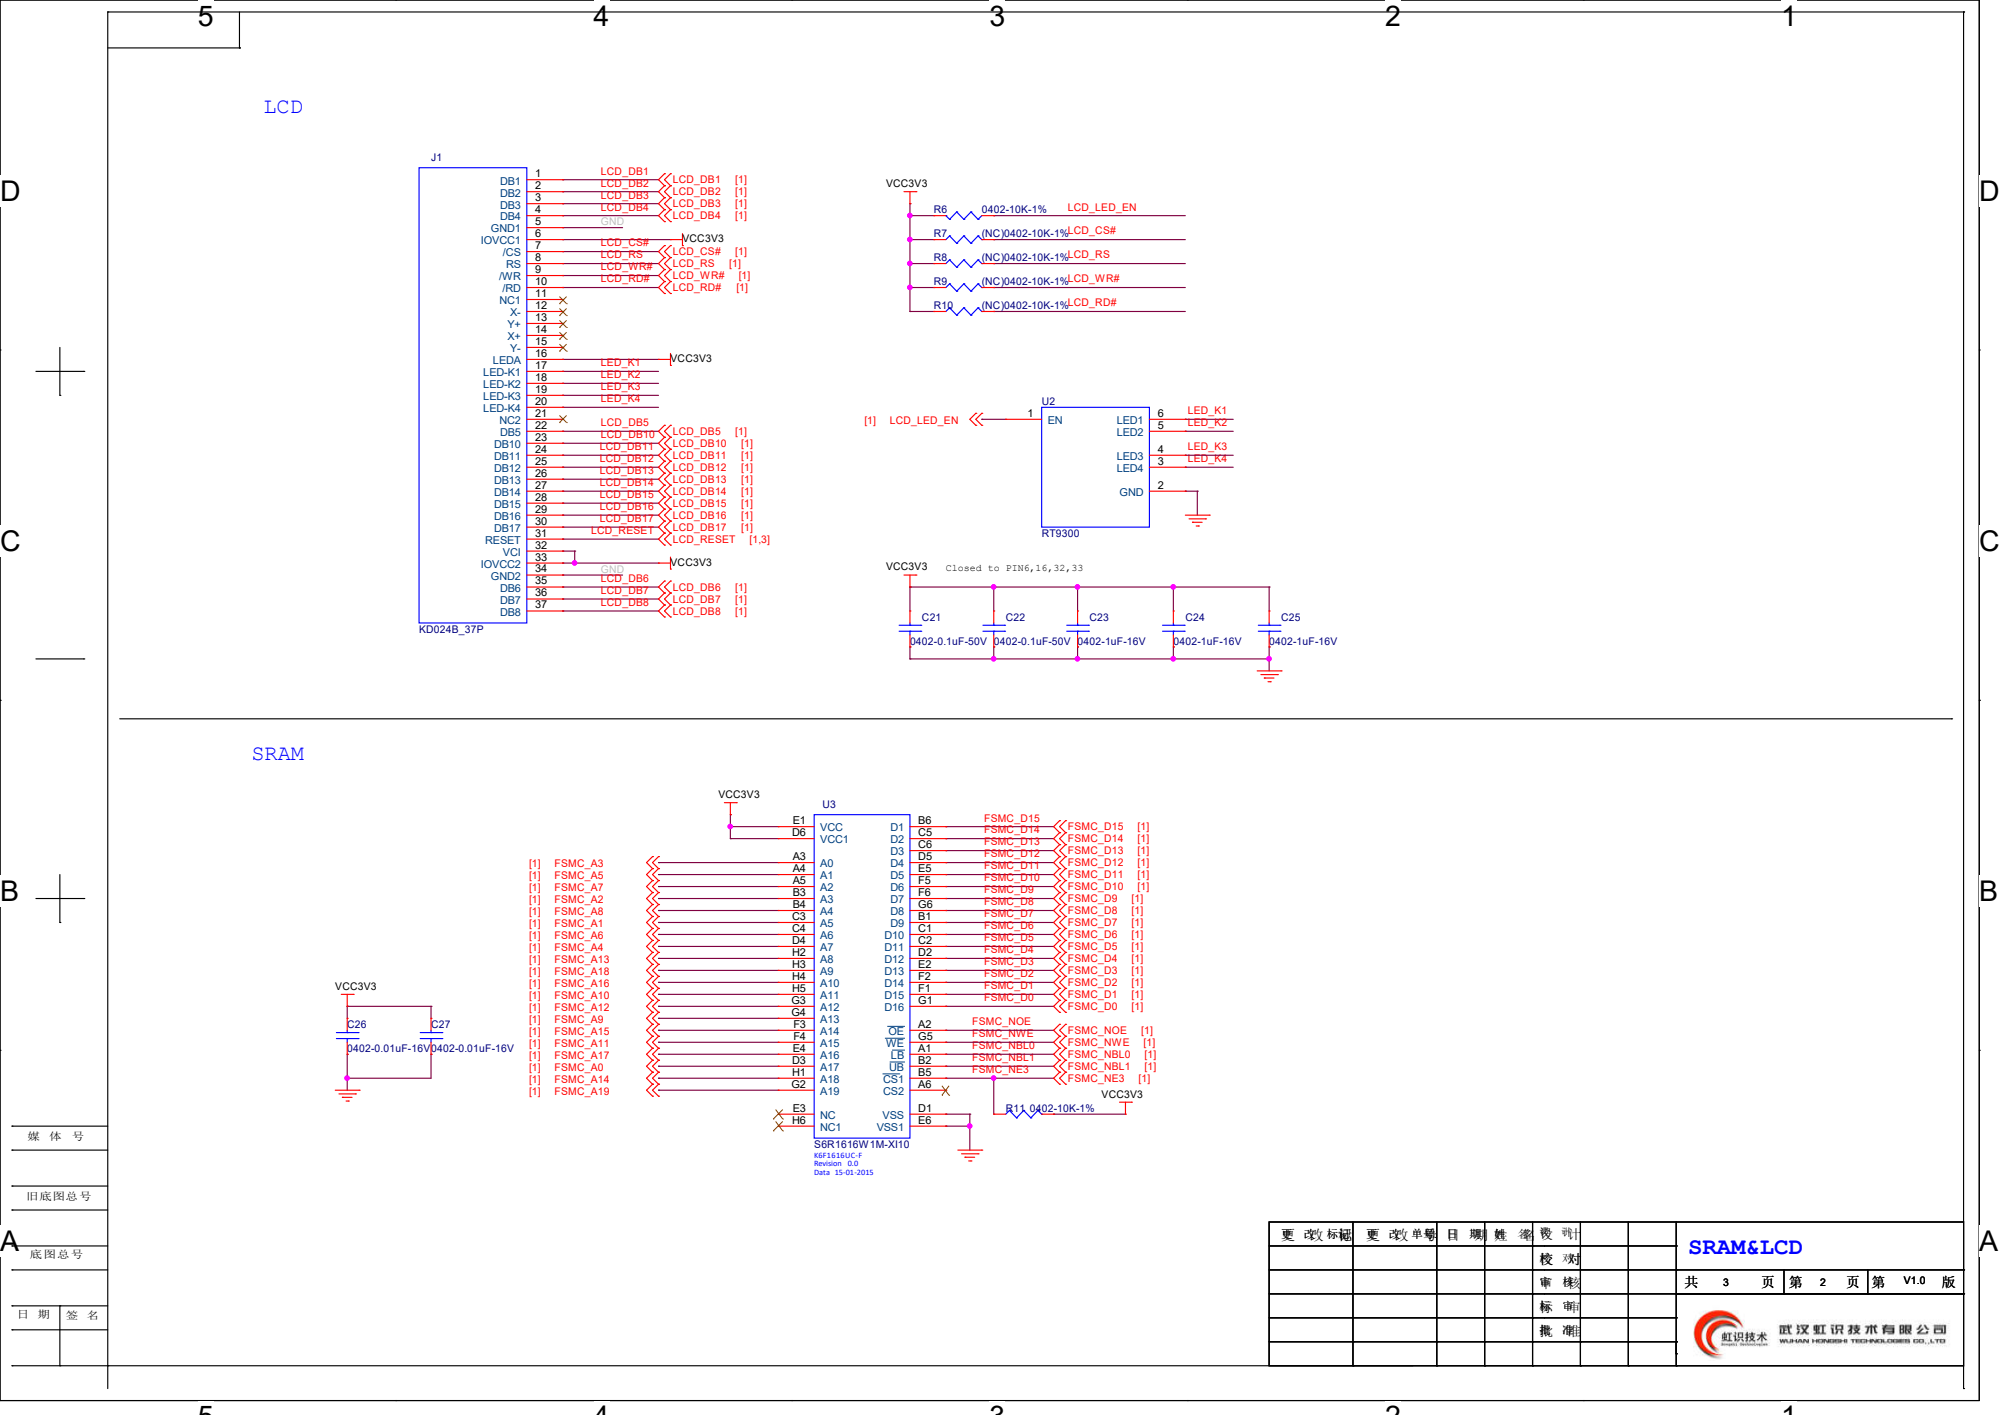
[picture p52: page 2]

校 对 校 对 校 对
审 核 审 核 审 核 | 共 共 共 3 3 3 页 页 页 | 第 第 第 2 2 2 页 页 页 | 第 第 第 V1.0 V1.0 V1.0 版 版 版

D | D

# BEEP

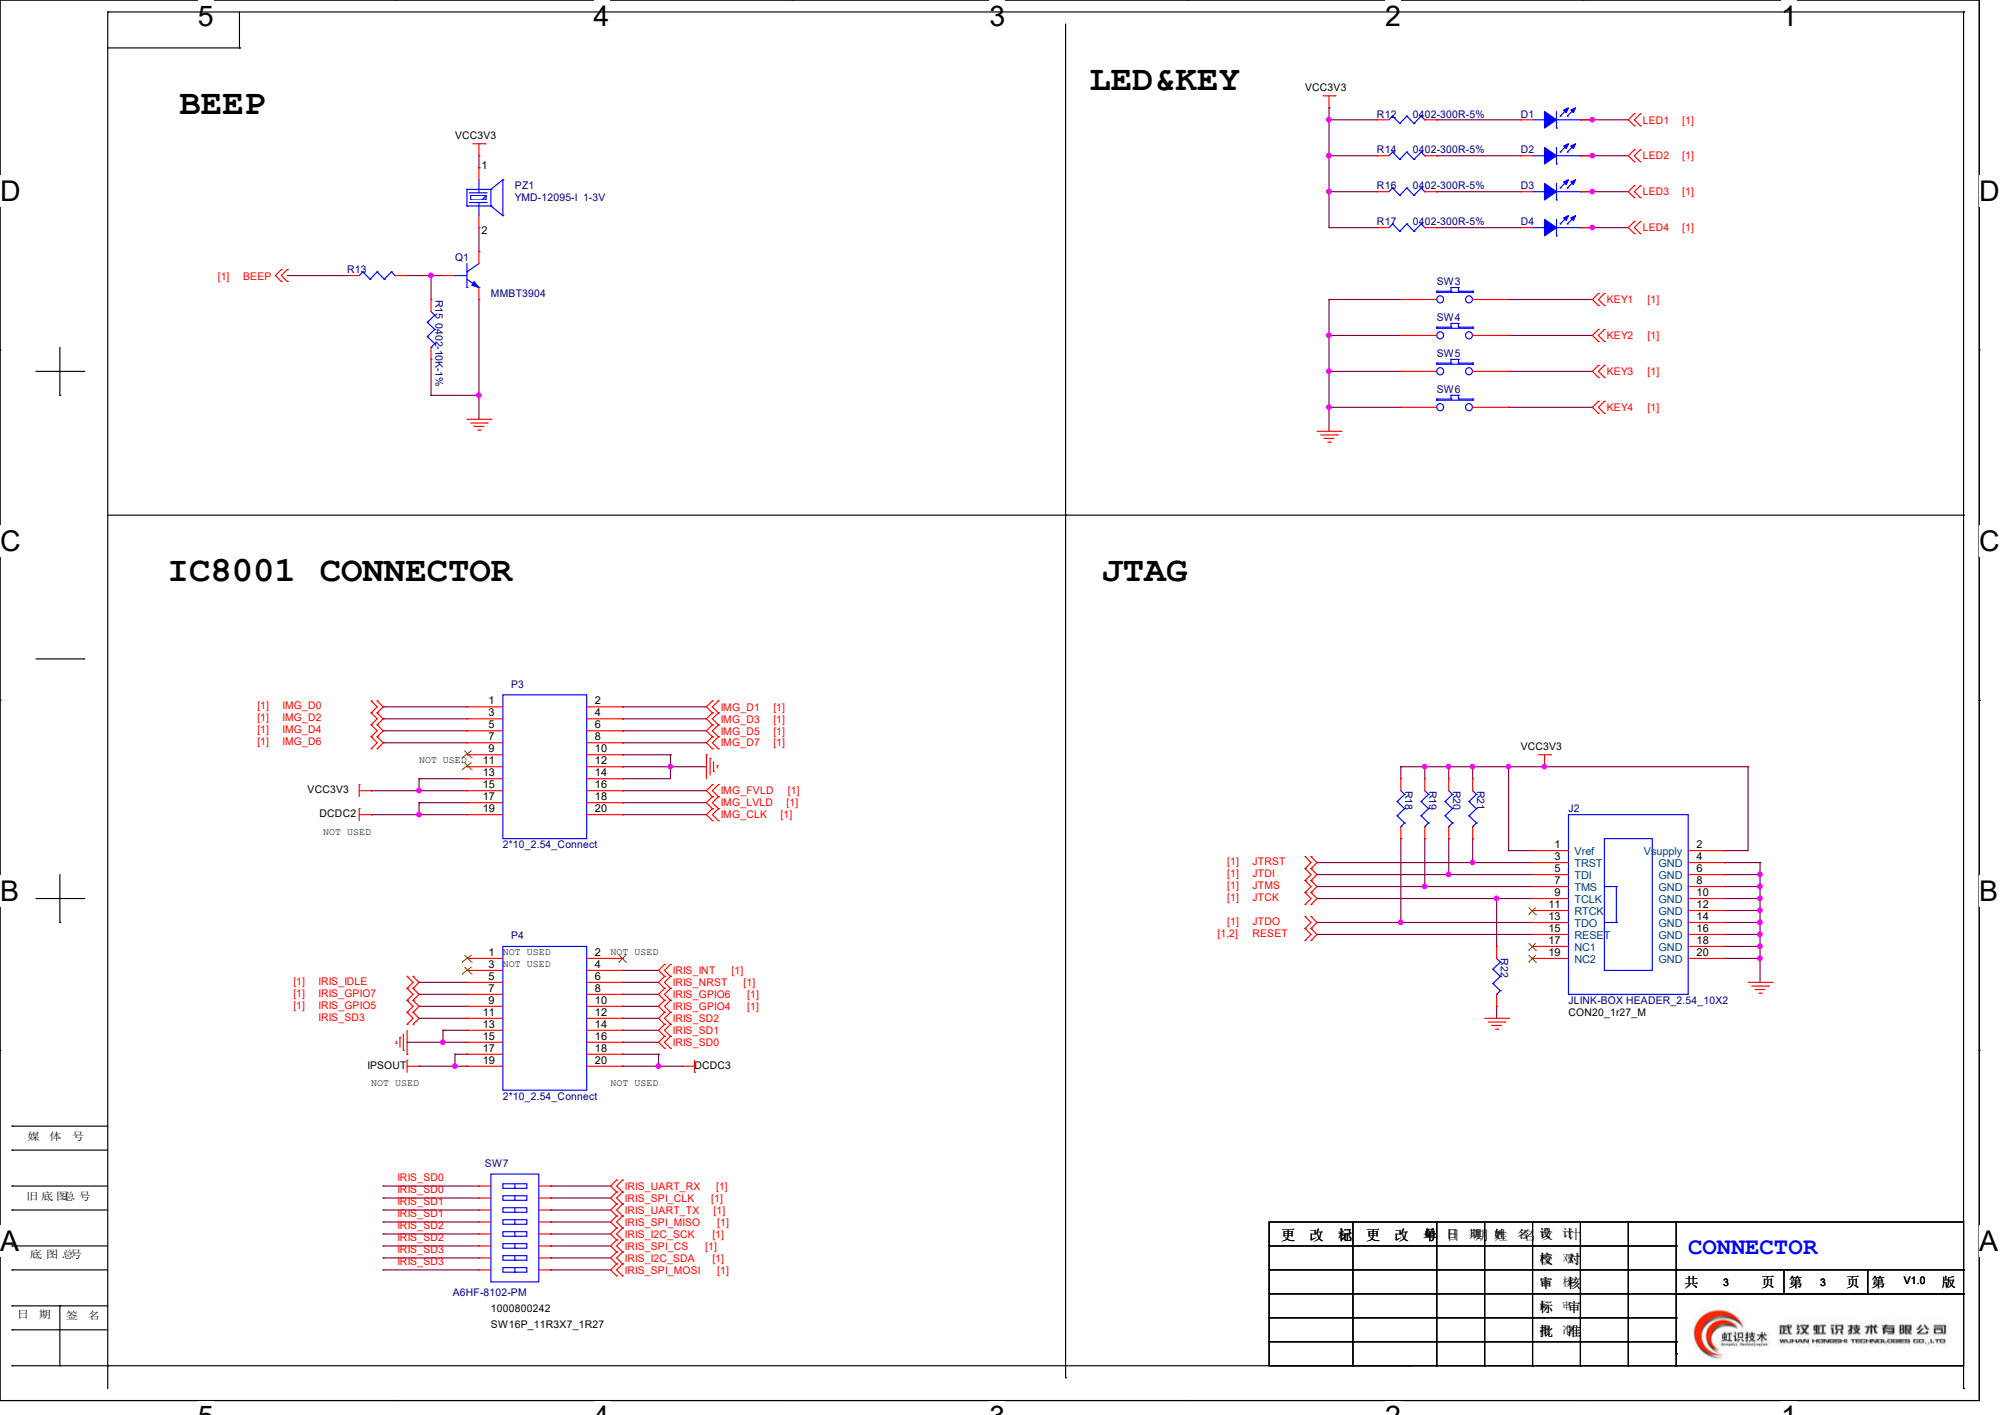
[picture p53: page 3]
