machunyu/HC8001/Sch/ICM4001.pdf

D | D

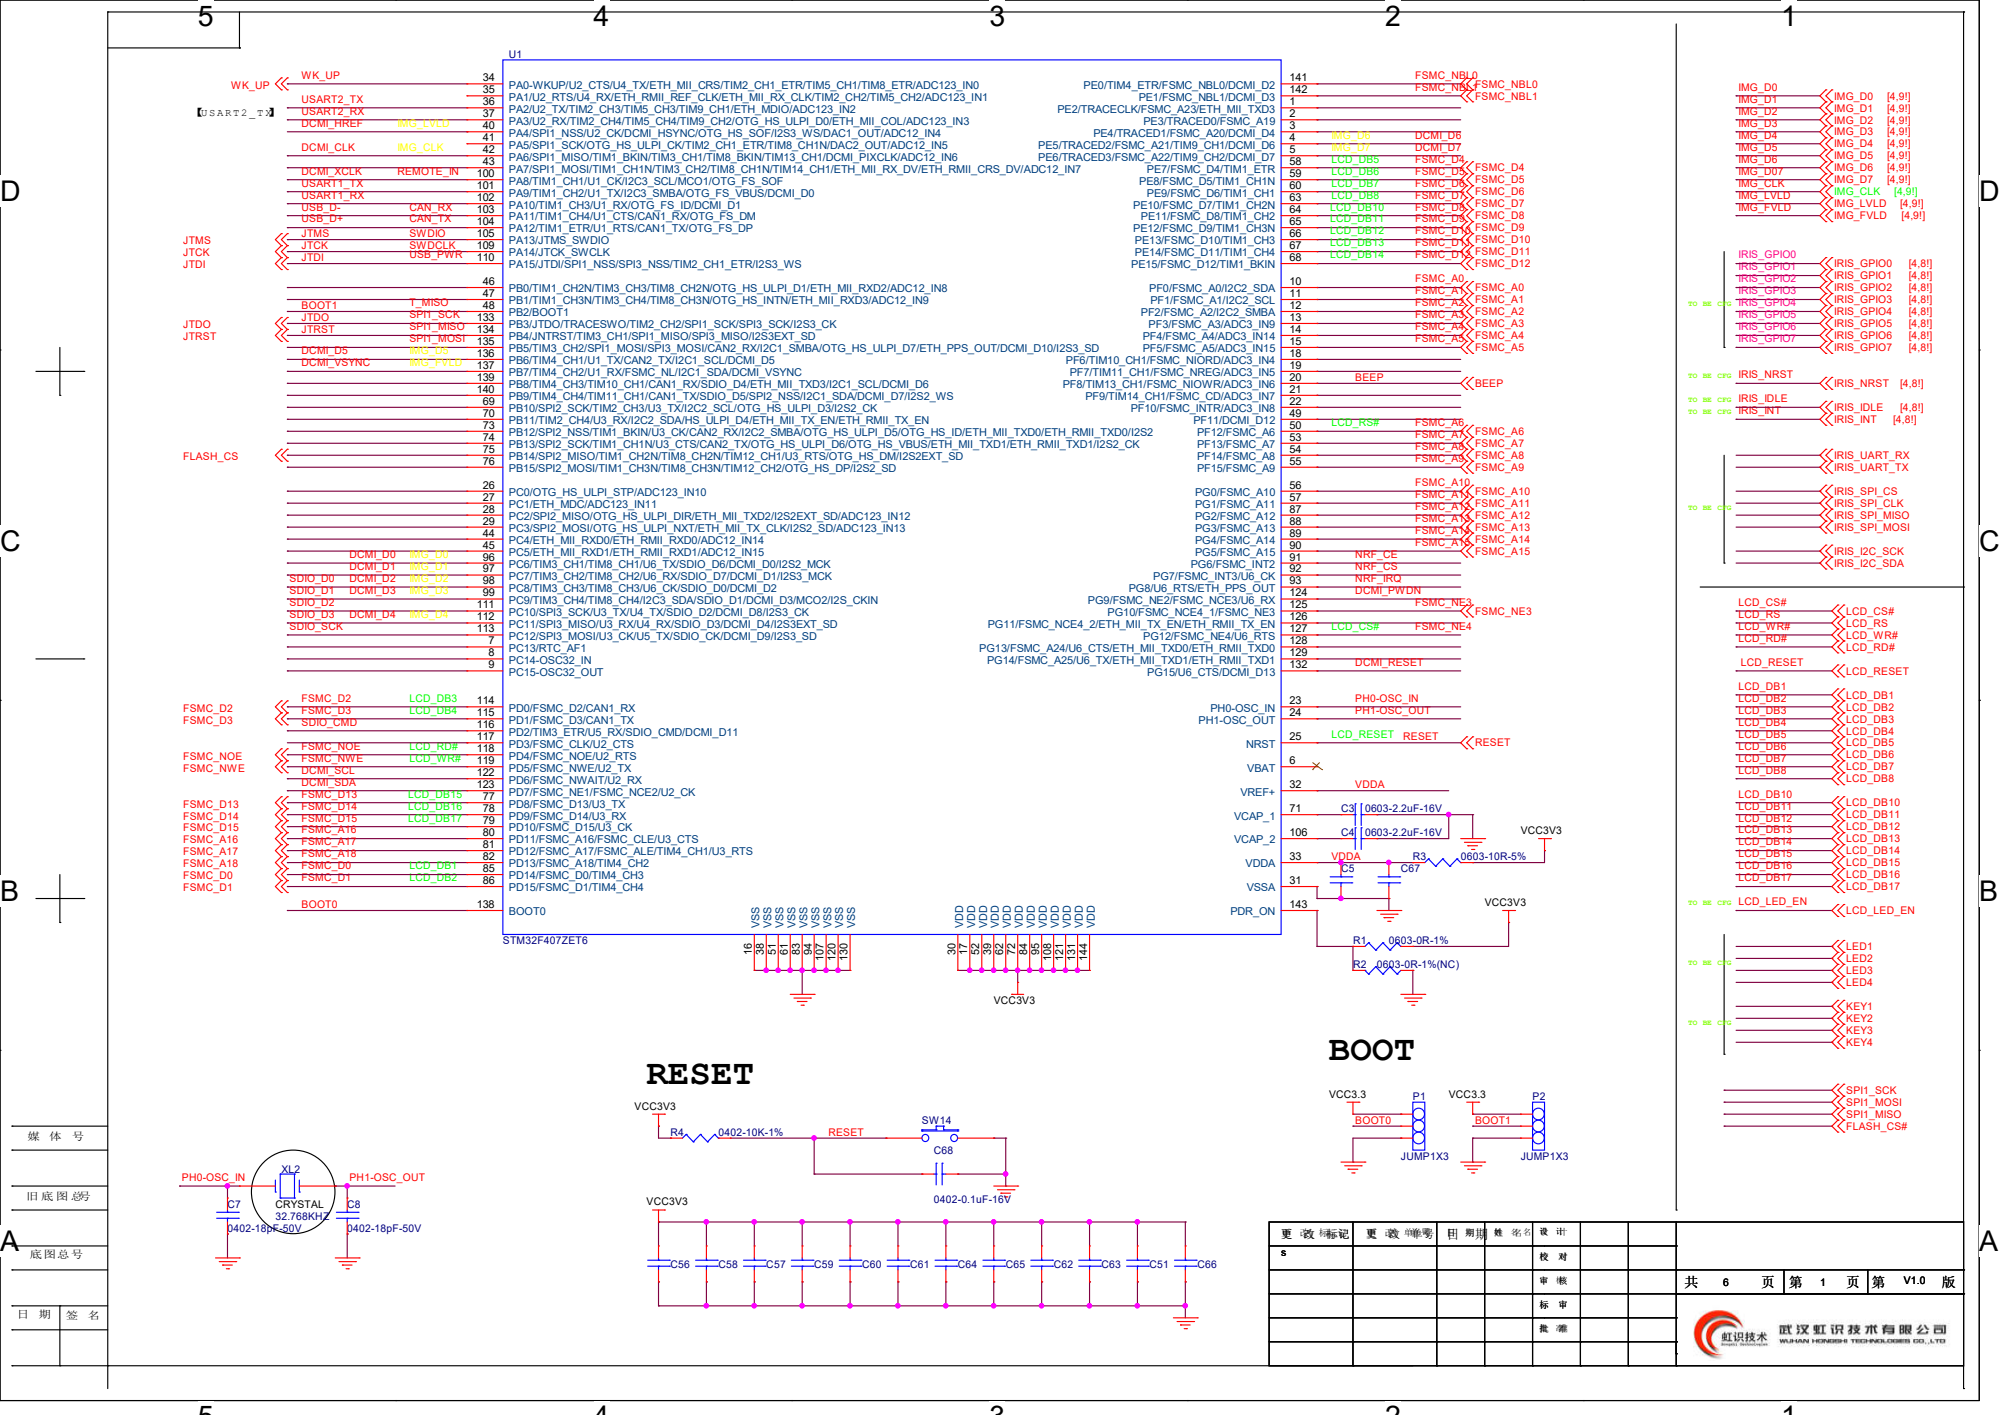
[picture p54: page 1]

D | D

## LCD

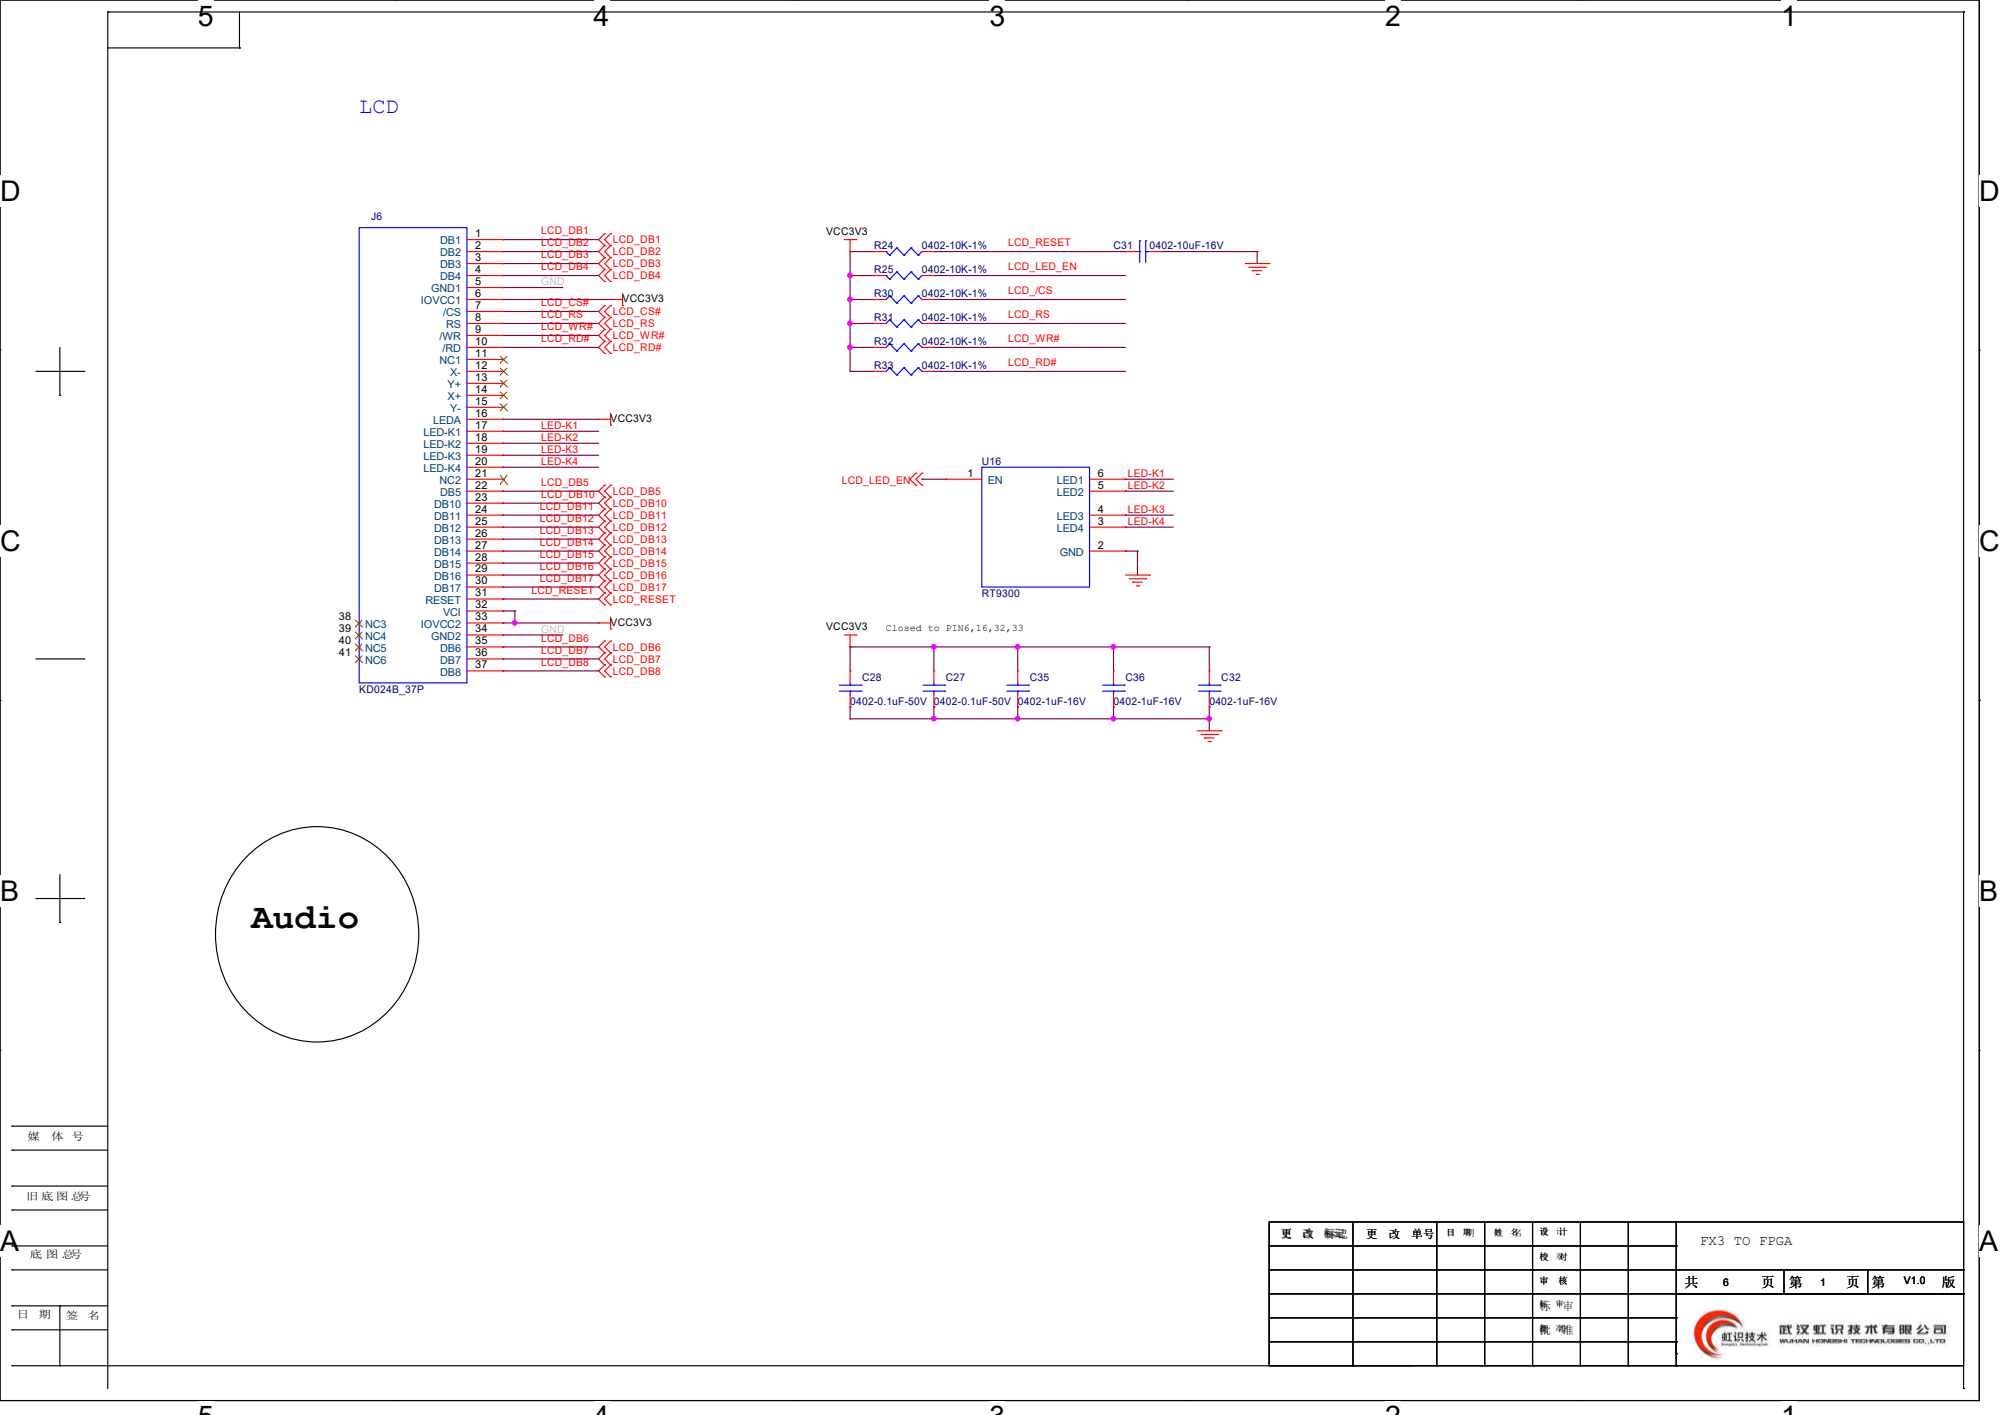
[picture p55: page 2]

D | D

## SRAM

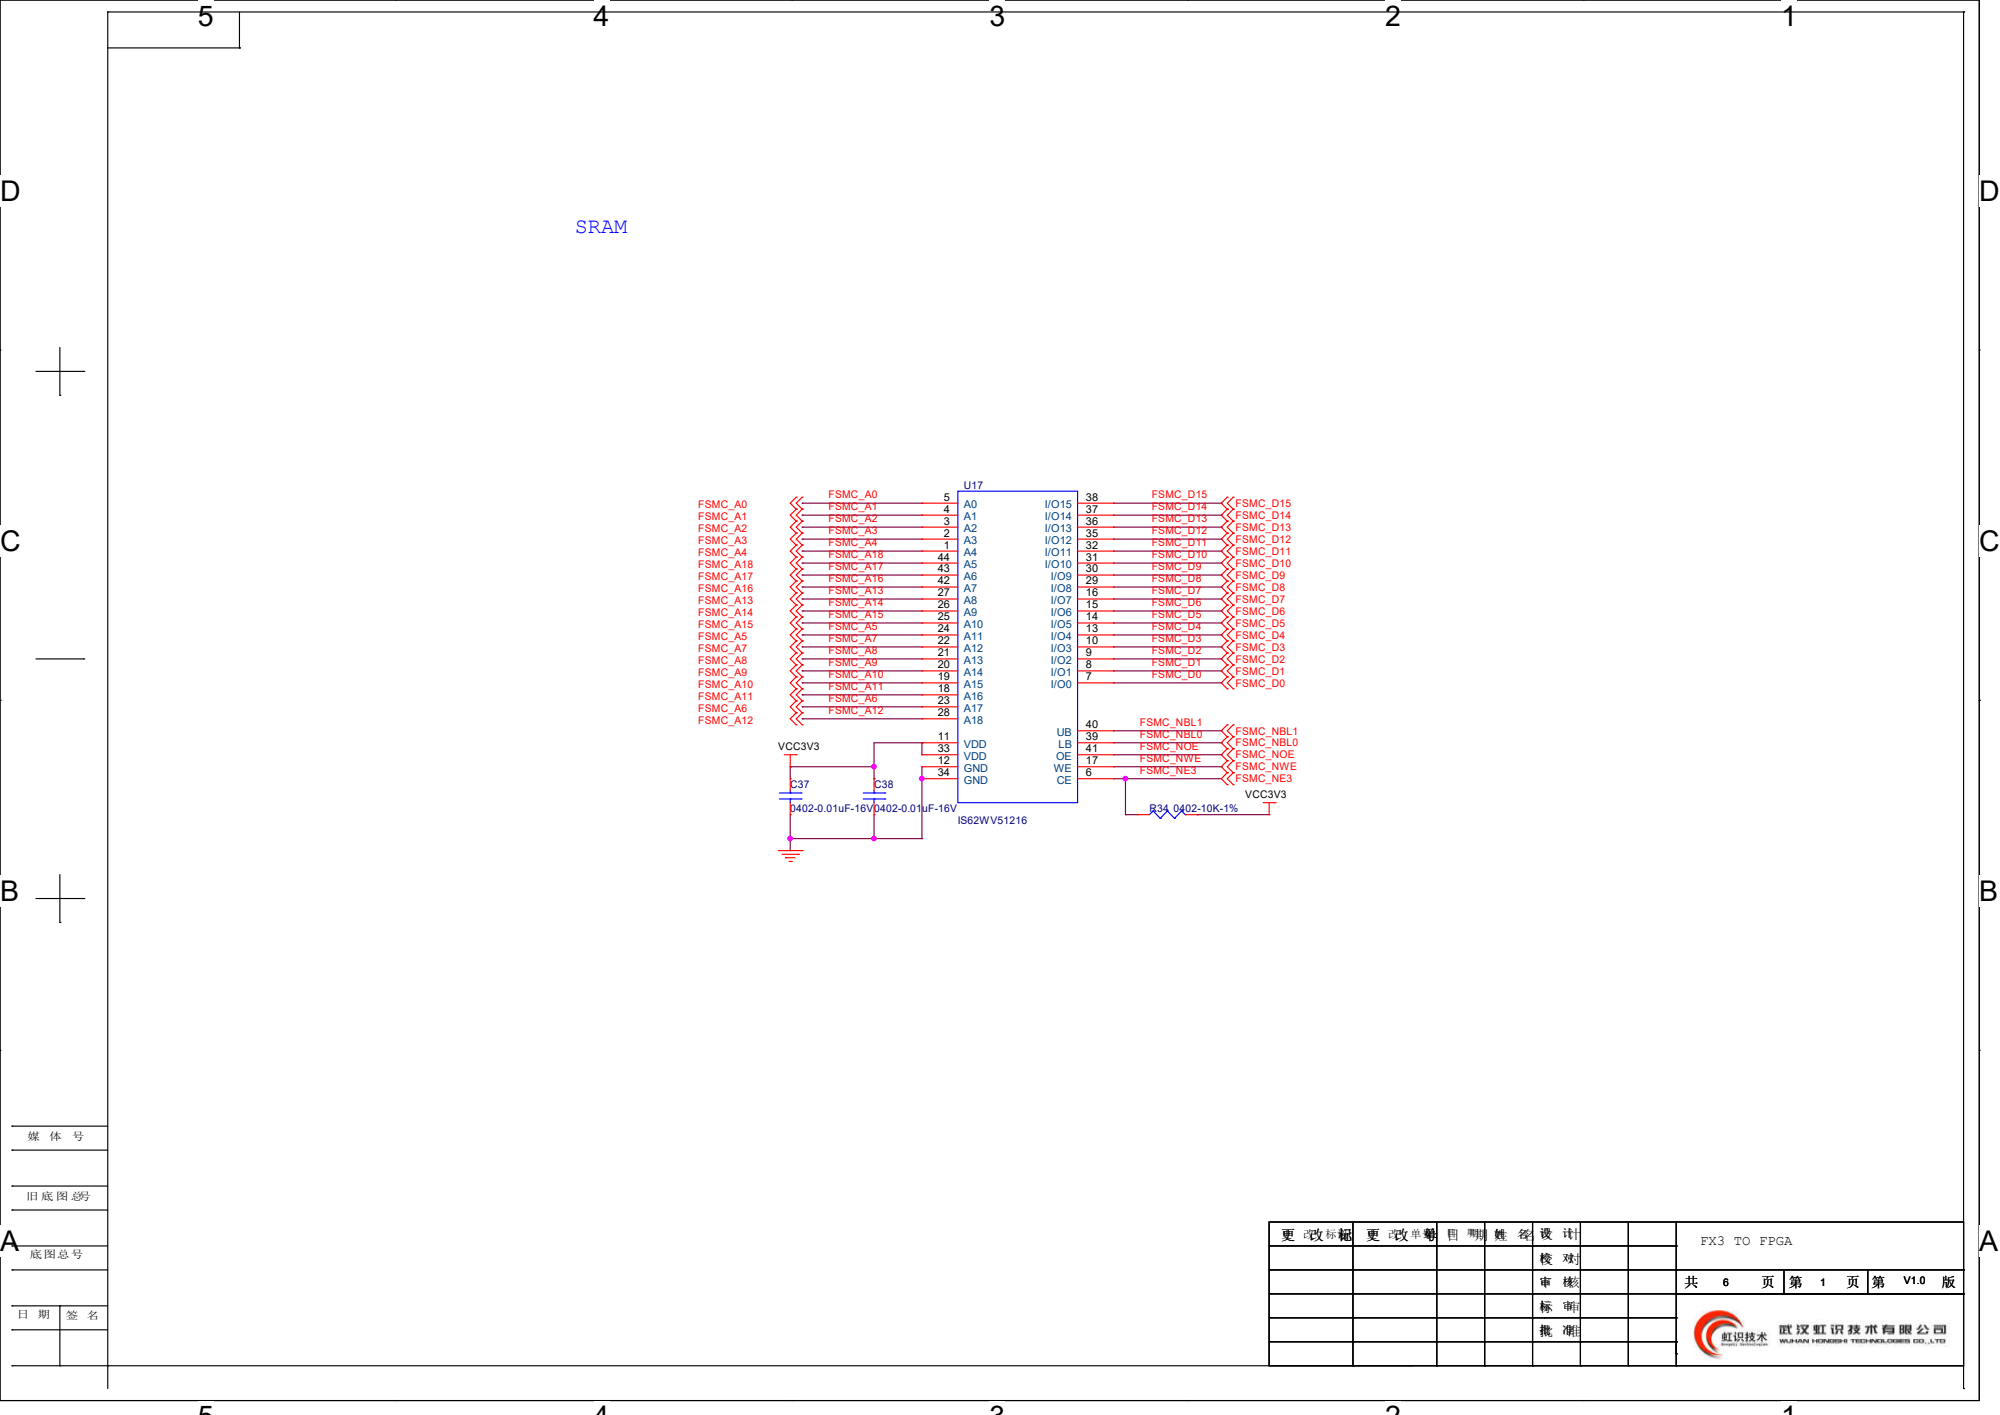
[picture p56: page 3]
底图总号; FX3 TO FPGA; FSMC_A0 FSMC_A1 FSMC_A2 FSMC_A3 FSMC_A4 FSMC_A18 FSMC_A17 FSMC_A16 FSMC_A13 FSMC_A14 FSMC_A15 FSMC_A5 FSMC_A7 FSMC_A8 FSMC_A9 FSMC_A10 FSMC_A11 FSMC_A6 FSMC_A12; FSMC_D15 FSMC_D14 FSMC_D13 FSMC_D12 FSMC_D11 FSMC_D10 FSMC_D9 FSMC_D8 FSMC_D7 FSMC_D6 FSMC_D5 FSMC_D4 FSMC_D3 FSMC_D2 FSMC_D1 FSMC_D0; FSMC_NBL1 FSMC_NBL0 FSMC_NOE FSMC_NWE FSMC_NE3; VCC3V3; FSMC_D0; FSMC_D1; FSMC_D2; FSMC_D3; FSMC_D4; FSMC_D5; FSMC_D6; FSMC_D7; FSMC_D8; FSMC_D9; FSMC_D10; FSMC_D11; FSMC_D12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

校 对 校 对 校 对
审 核 审 核 审 核 | 共 共 共 6 6 6 页 页 页 | 第 第 第 1 1 1 页 页 页 | 第 第 第 V1.0 V1.0 V1.0 版 版 版

D | D

## E2PROM

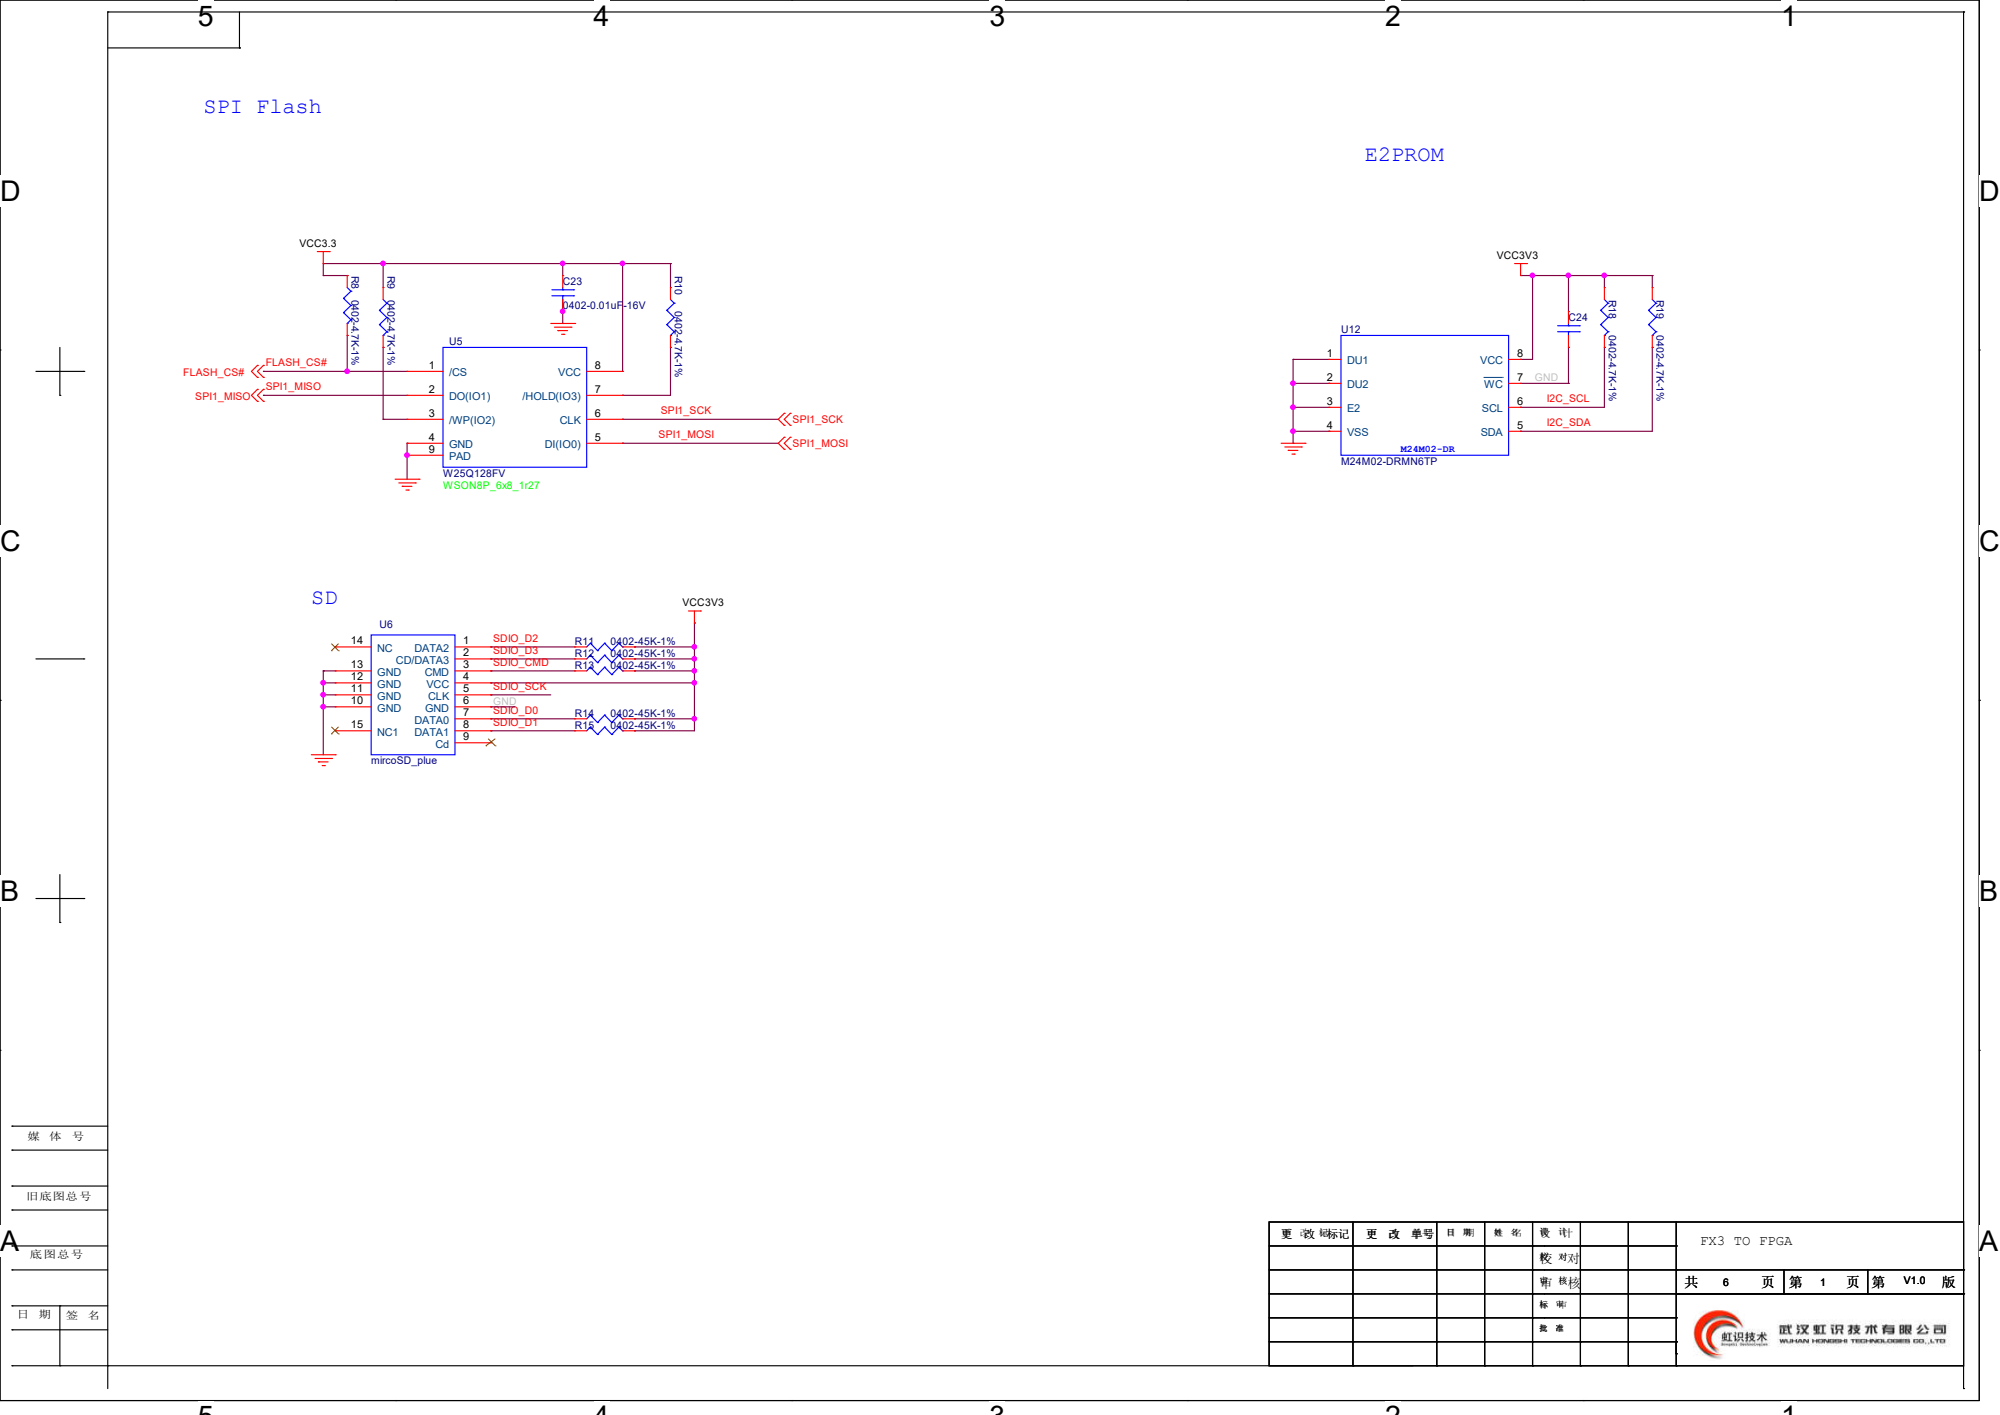
[picture p57: page 4]

D | D

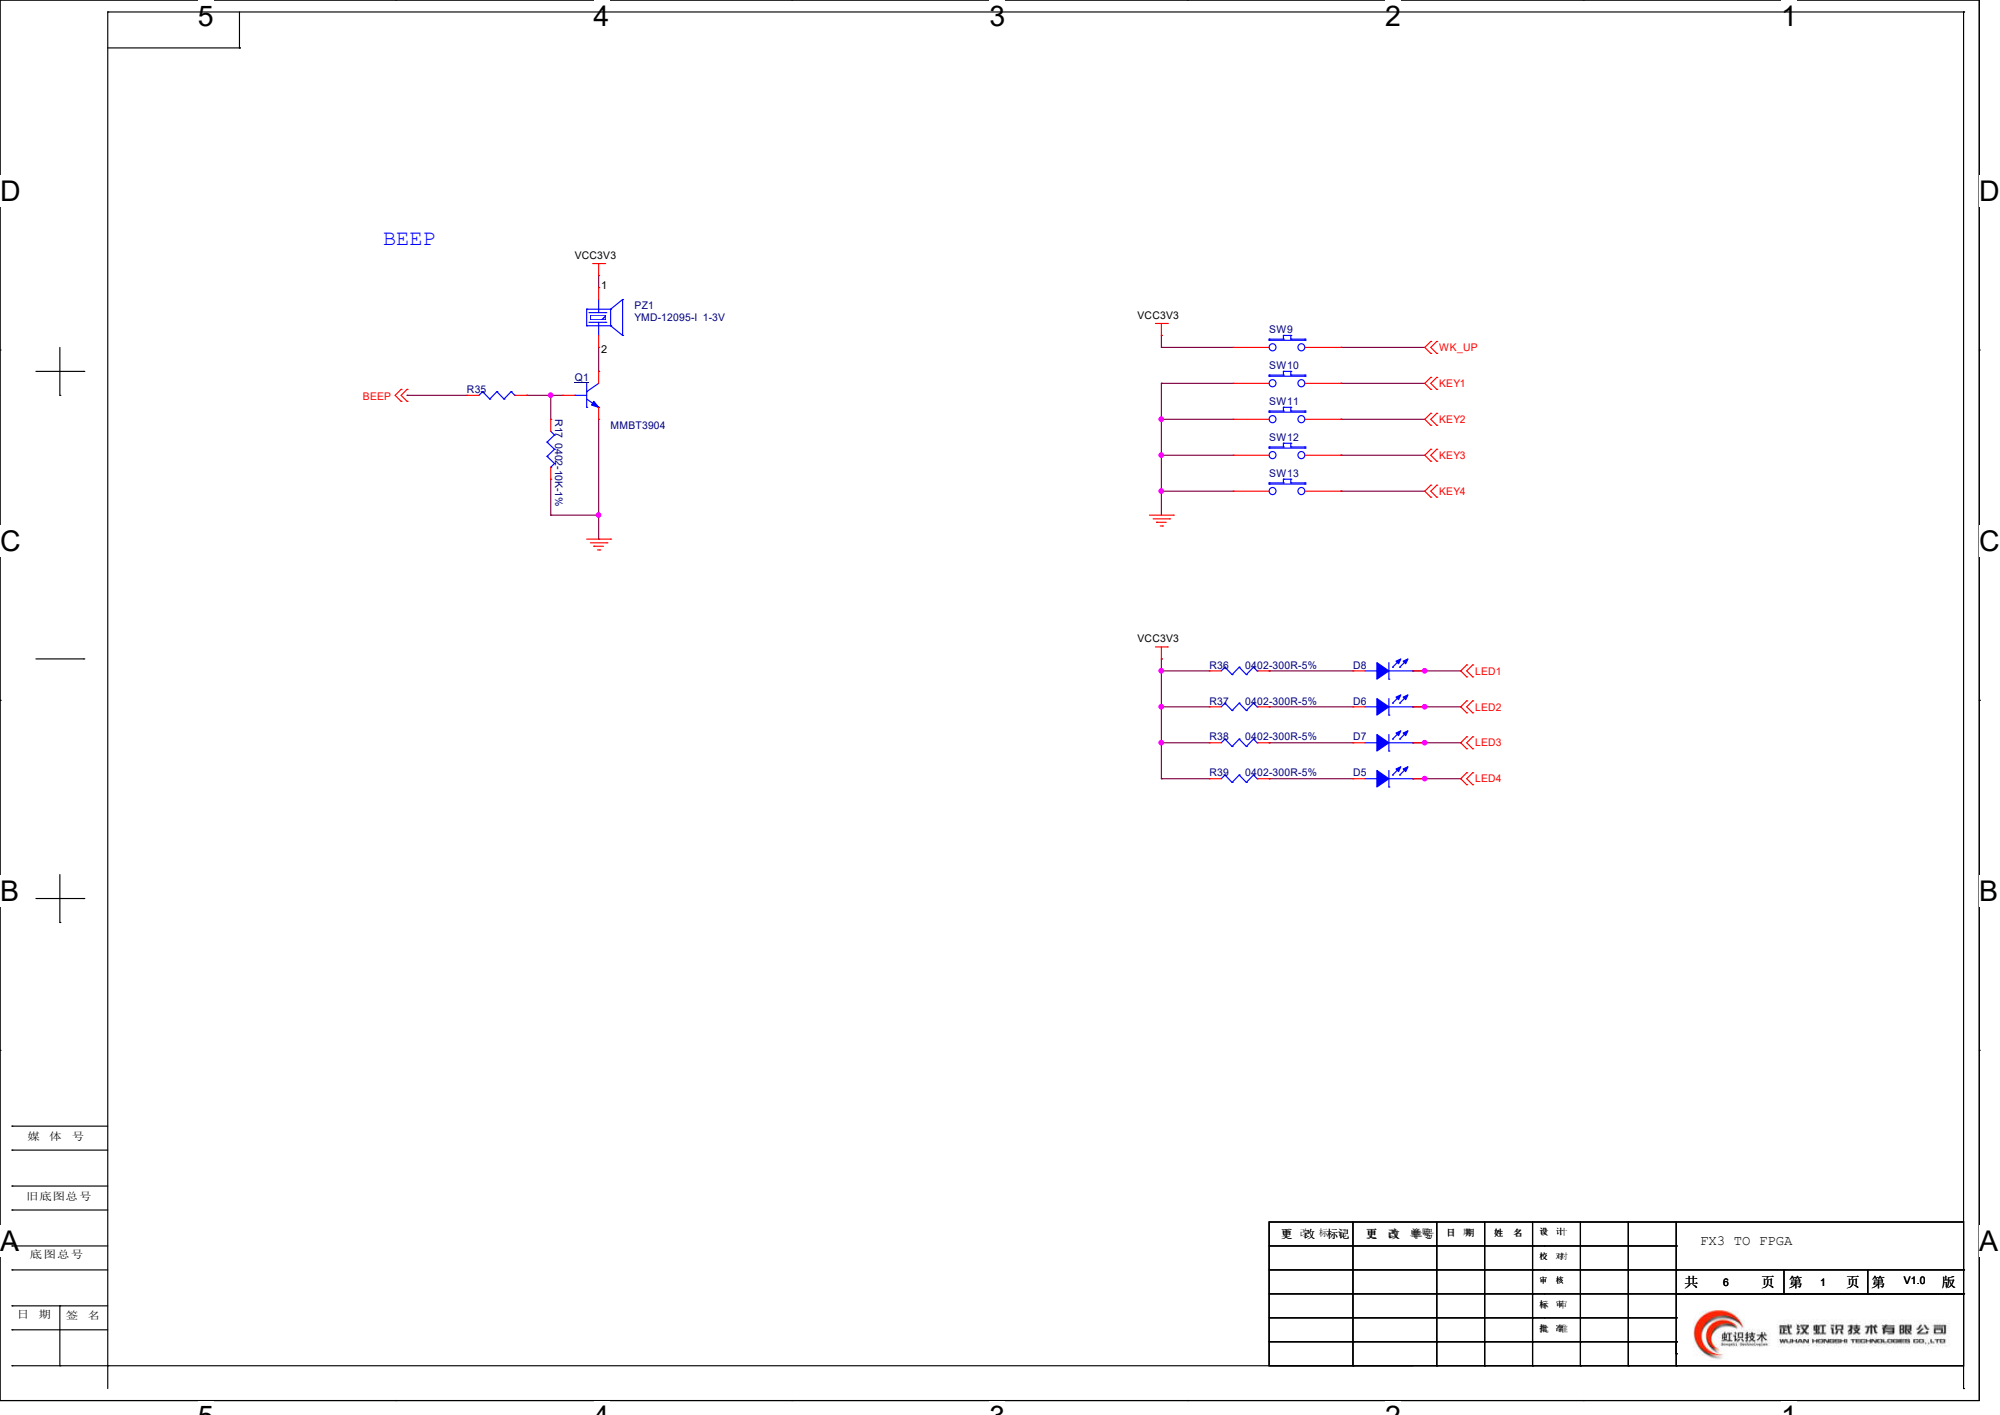
[picture p58: page 5]

D | D

## HSIC8001 CONNECTOR

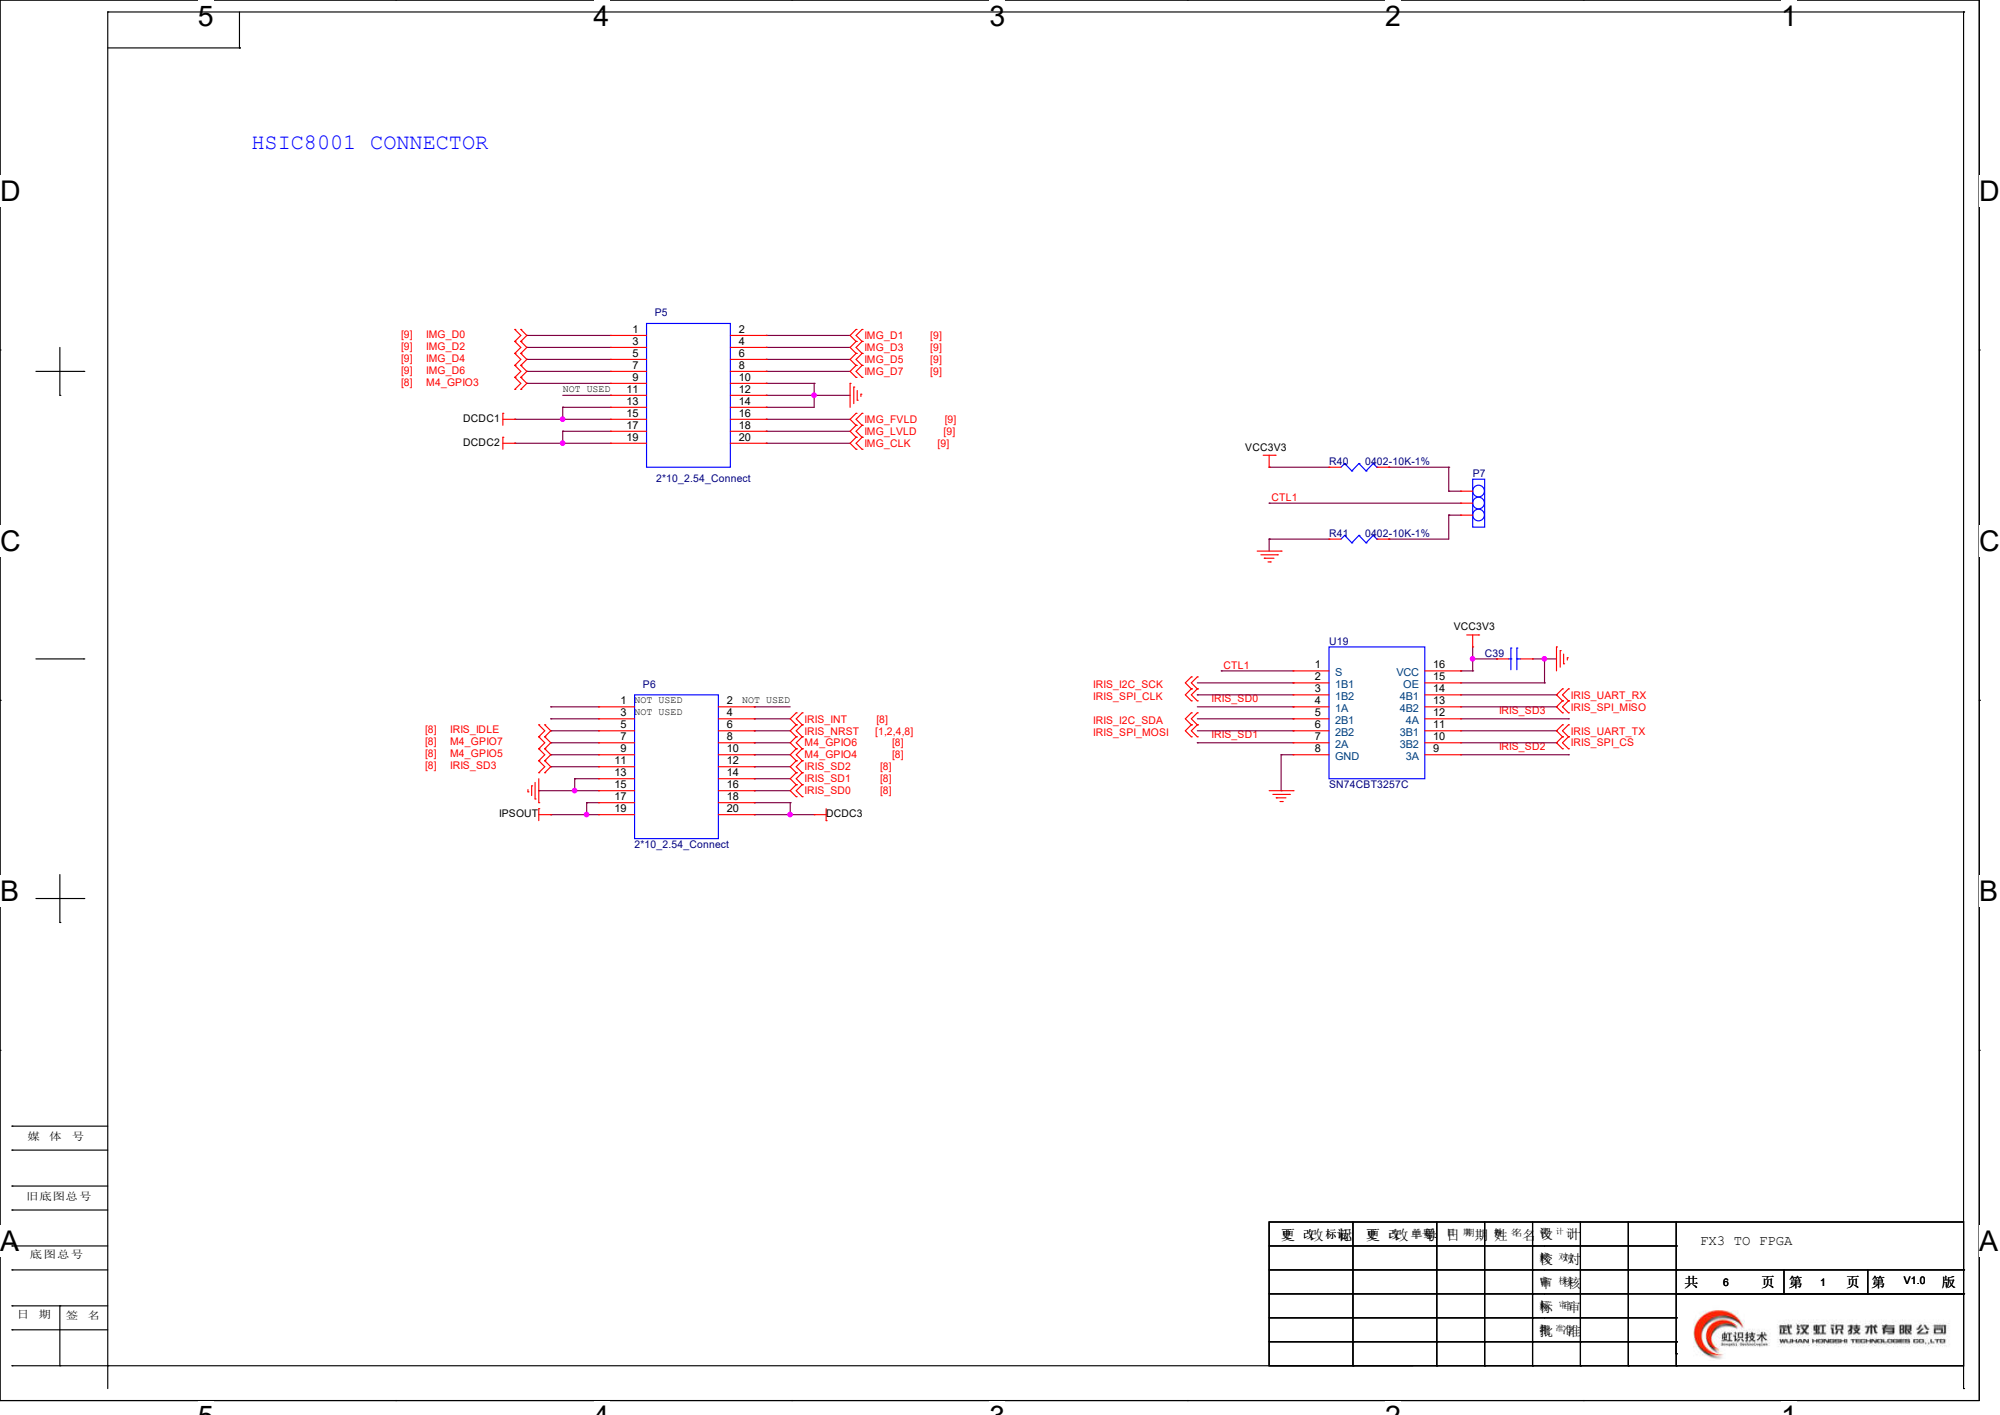
[picture p59: page 6]
底图总号; 旧底图总号; FX3 TO FPGA; NOT USED NOT USED; NOT USED; IRIS_SD0; IRIS_SD1; IRIS_SD2; IRIS_SD3; CTL1; IPSOUT; DCDC3; DCDC1; DCDC2; VCC3V3; M4_GPIO6; M4_GPIO4; IRIS_NRST; IRIS_INT; [8] IRIS_IDLE [8] M4_GPIO7; [8] M4_GPIO3; IMG_D1; IMG_D3; IMG_D5; IMG_D7; [9] IMG_D0 [9] IMG_D2 [9] IMG_D4 [9] IMG_D6; IMG_FVLD; IMG_LVLD; IMG_CLK; [8] M4_GPIO5 [8] IRIS_SD3; IRIS_I2C_SCK IRIS_SPI_CLK; IRIS_I2C_SDA IRIS_SPI_MOSI; IRIS_UART_RX IRIS_SPI_MISO; IRIS_UART_TX IRIS_SPI_CS; 2*10_2.54_Connect; SN74CBT3257C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

D | D

# JTAG

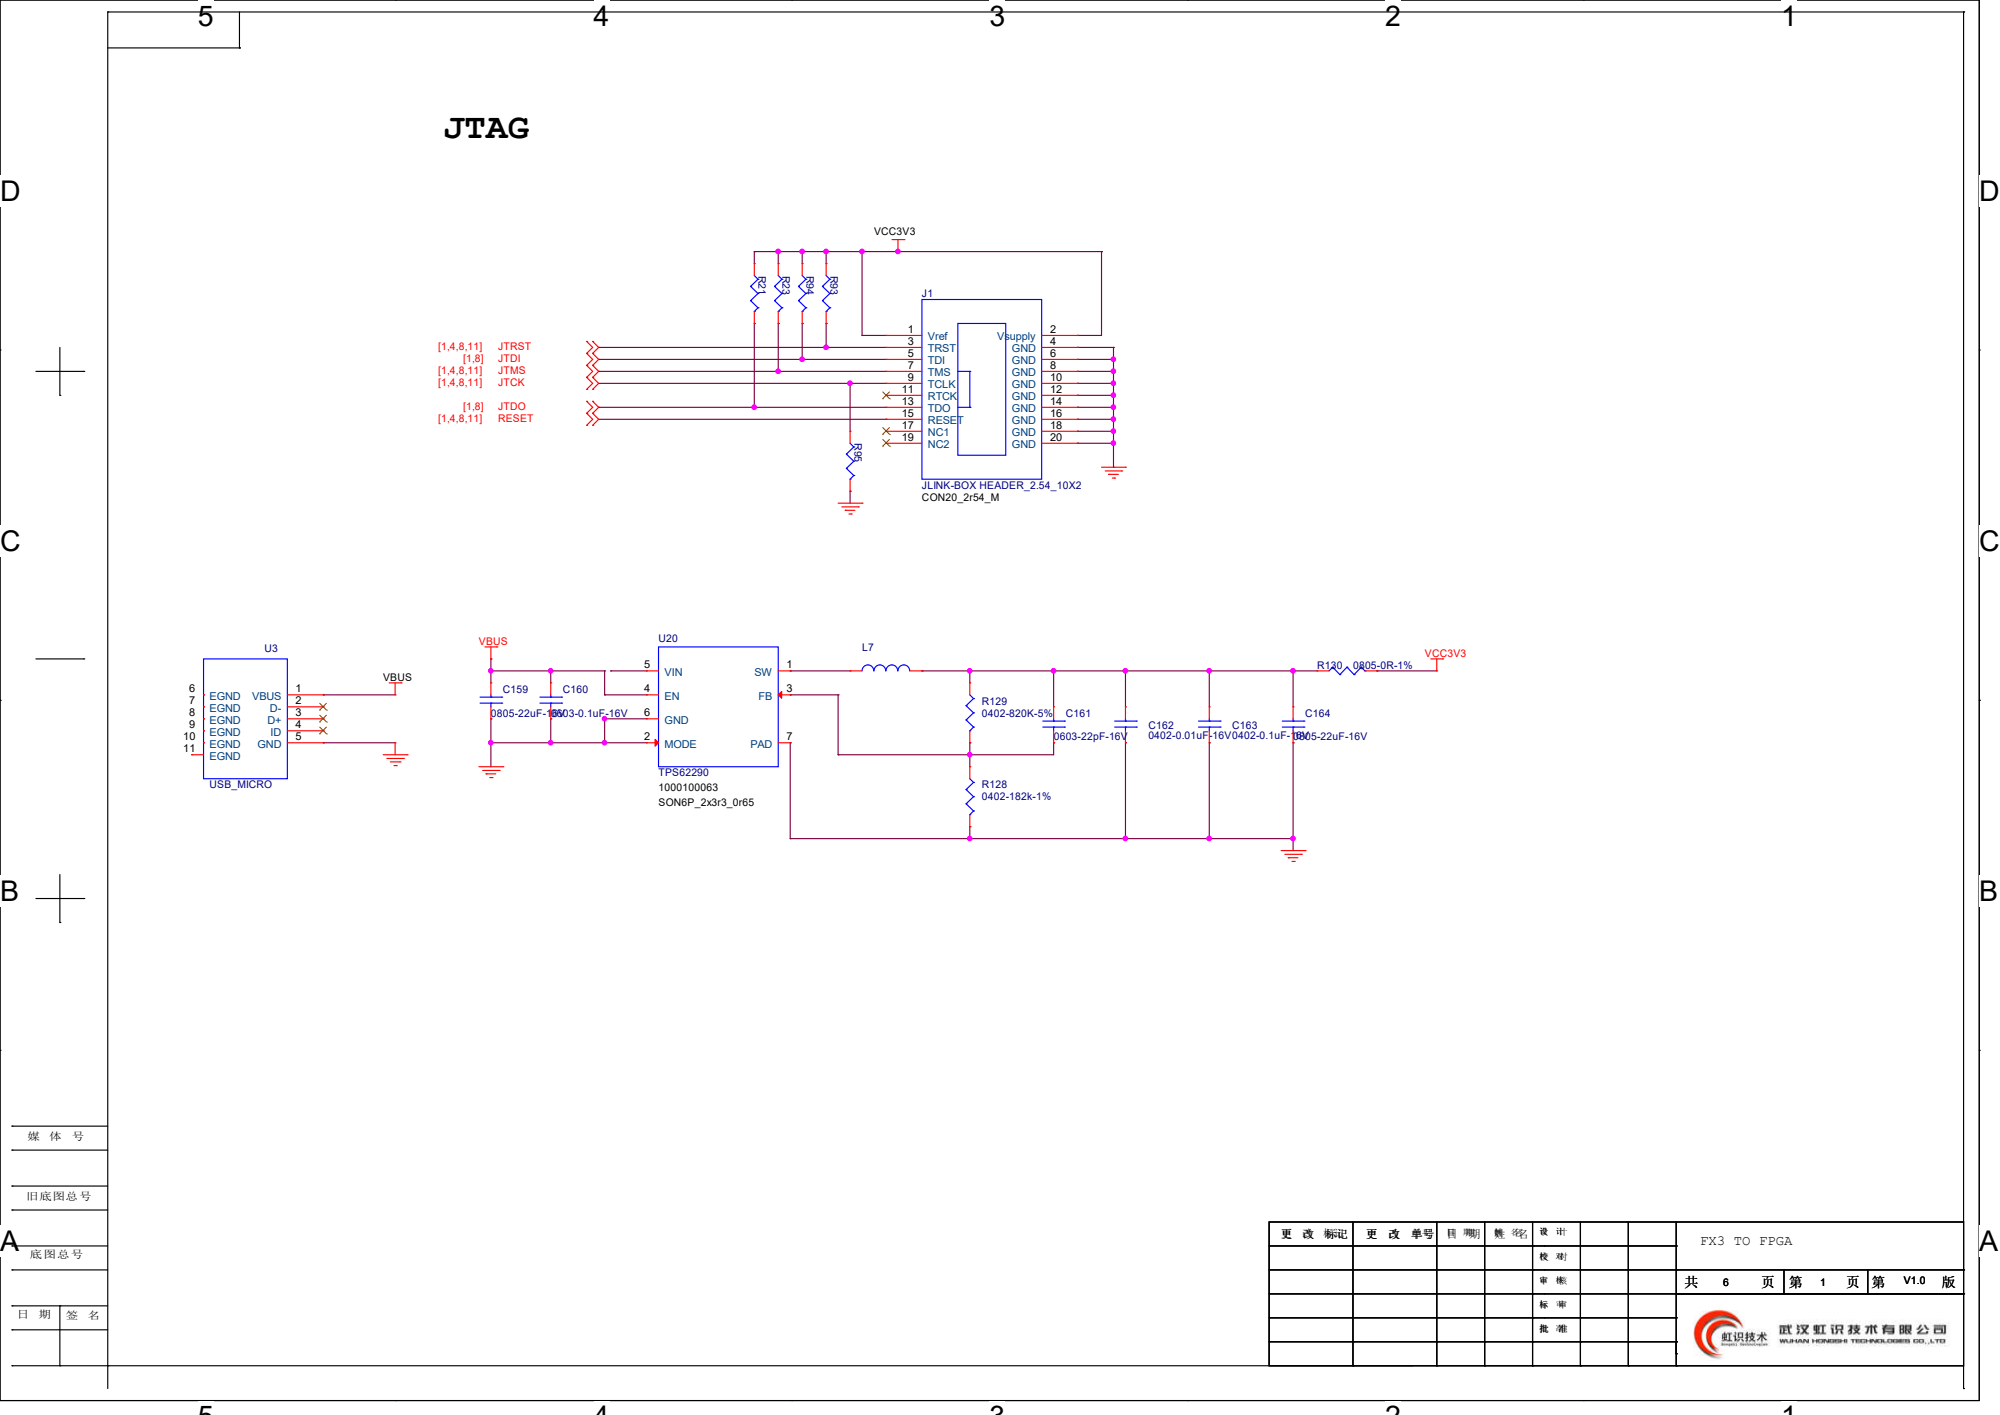
[picture p60: page 7]

D | D
C | C
B | B
A | A

媒 体 号

底图总号

旧底图总号

FX3 TO FPGA

共 | 页 | 第 | 页 | 第 | 版

设 计

校 对

审 核

更 改 标记 | 更 改 单号 | 日 期 | 姓 名
共 | 6 | 页 | 第 | 1 | 页 | 第 | V1.0 | 版

设 计

校 对

审 核

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

设 计

校 对

审 核

更 改 标记 | 更 改 单号 | 日 期 | 姓 名
6 | 1 | V1.0

D | D
C | C
B | B
A | A

媒 体 号

底图总号

旧 底 图 总号

FX3 TO FPGA

共 | 页 | 第 | 页 | 第 | 版

设 计

校 对

审 核

更 改 标 记 | 更 改 单号 | 日 期 | 姓 名
共 | 6 | 页 | 第 | 1 | 页 | 第 | V1.0 | 版

设 计

校 对

审 核

更 改 标记 | 更 改 单号 | 日 期 | 姓 名
共 | 6 | 页 | 第 | 1 | 页 | 第 | V1.0 | 版
设 | 计

校 对

审 核

更 改 标记 | 更 改 单号 | 日 期 | 姓 名
6 | 1 | V1.0

D | D
C | C
B | B
A | A

媒 体 号

底图总号

旧底图总号

FX3 TO FPGA

共 | 页 | 第 | 页 | 第 | 版

设 计

校 对

审 核

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

设 计

校 对

审 核

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

设 计

校 对

审 核

更 改 标记 | 更 改 单号 | 日 期 | 姓 名
6 | 1 | V1.0

D | D
C | C
B | B
A | A

媒 体 号

底图总号

旧 底 图 总号

FX3 TO FPGA

共 | 页 | 第 | 页 | 第 | 版

设 计

校 对

审 核

更 改 标记 | 更 改 单 号 | 日 期 | 姓 名
共 | 6 | 页 | 第 | 1 | 页 | 第 | V1.0 | 版

设 计

校 对

审 核

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

设 计

校 对

审 核

更 改 标 记 | 更 改 单号 | 日 期 | 姓 名
6 | 1 | V1.0
