machunyu/HC8001/Sch/ICM4003_0703 (G).pdf

5

4

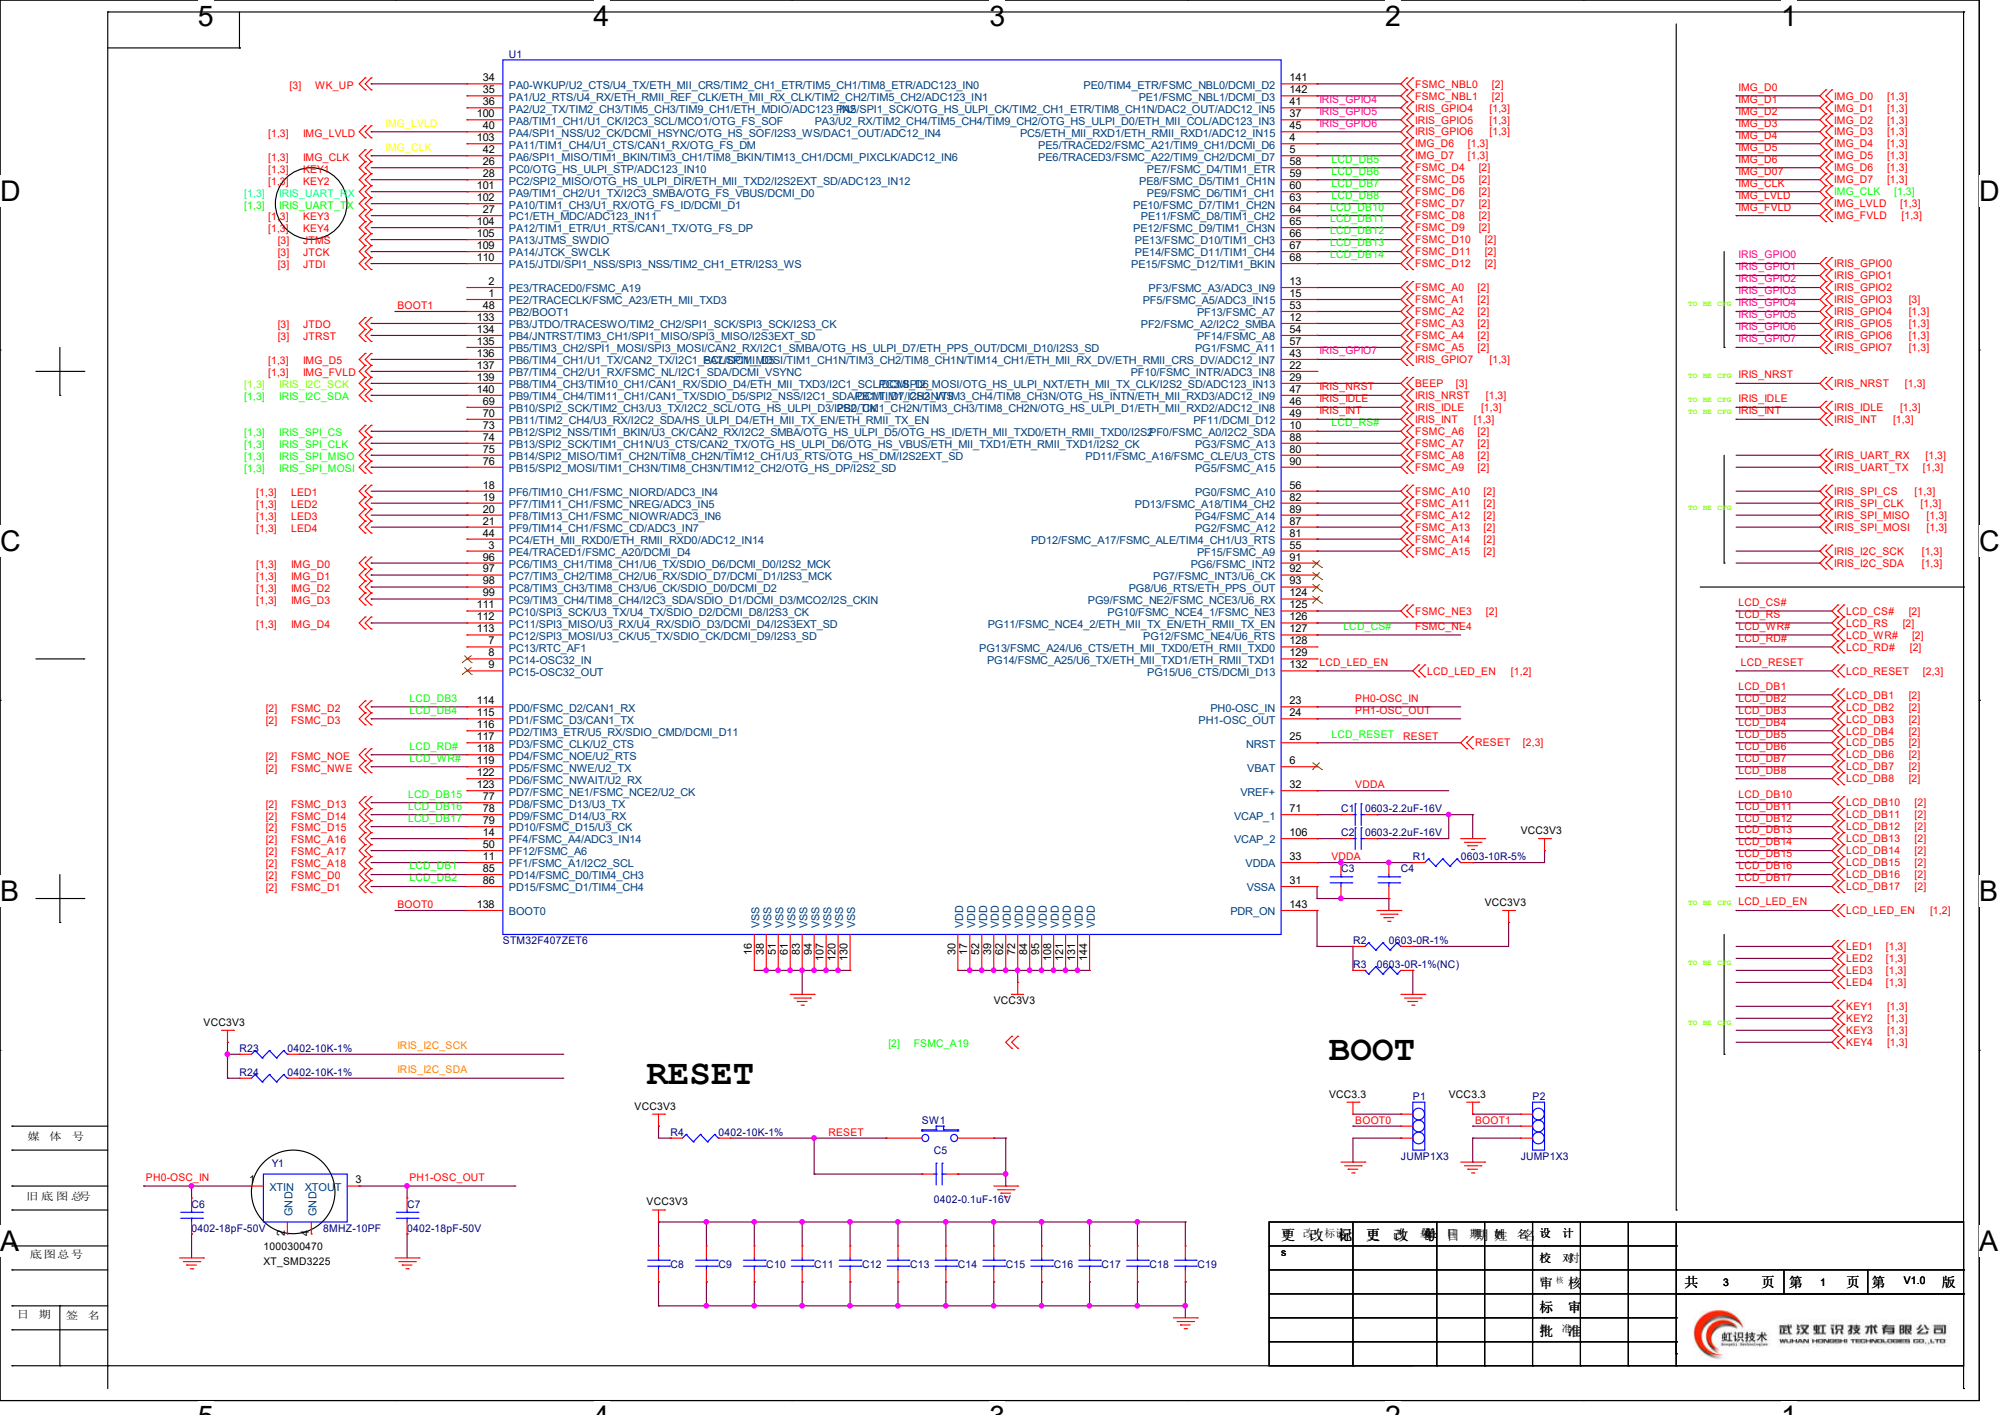
[picture p61: page 1]
