machunyu/HC8001/Source Code/M4_VIdeoDisplay/Cam_Master_I2c/HARDWARE/SPI/spi.c

#include "spi.h"
//////////////////////////////////////////////////////////////////////////////////	 
//本程序只供学习使用，未经作者许可，不得用于其它任何用途
//ALIENTEK STM32F407开发板
//SPI 驱动代码	   
//正点原子@ALIENTEK
//技术论坛:www.openedv.com
//创建日期:2014/5/6
//版本：V1.0
//版权所有，盗版必究。
//Copyright(C) 广州市星翼电子科技有限公司 2014-2024
//All rights reserved									  
////////////////////////////////////////////////////////////////////////////////// 	 


//以下是SPI模块的初始化代码，配置成主机模式 						  
//SPI口初始化
//这里针是对SPI1的初始化
void SPI2_Init(void)
{	 
  GPIO_InitTypeDef  GPIO_InitStructure;
  SPI_InitTypeDef  SPI_InitStructure;
	
  RCC_AHB1PeriphClockCmd(RCC_AHB1Periph_GPIOB, ENABLE);//使能GPIOA时钟
  RCC_APB1PeriphClockCmd(RCC_APB1Periph_SPI2, ENABLE);//使能SPI2时钟
 
  //GPIOFB3,4,5初始化设置
  GPIO_InitStructure.GPIO_Pin = GPIO_Pin_12|GPIO_Pin_13|GPIO_Pin_14|GPIO_Pin_15;//PB3~5复用功能输出	
  GPIO_InitStructure.GPIO_Mode = GPIO_Mode_AF;//复用功能
  GPIO_InitStructure.GPIO_OType = GPIO_OType_PP;//推挽输出
  GPIO_InitStructure.GPIO_Speed = GPIO_Speed_100MHz;//100MHz
  GPIO_InitStructure.GPIO_PuPd = GPIO_PuPd_UP;//上拉
  GPIO_Init(GPIOB, &GPIO_InitStructure);//初始化
	
//	GPIO_InitStructure.GPIO_Pin = GPIO_Pin_12;//PB3~5复用功能输出	
//  GPIO_InitStructure.GPIO_Mode = GPIO_Mode_OUT;//复用功能
//  GPIO_InitStructure.GPIO_OType = GPIO_OType_PP;//推挽输出
//  GPIO_InitStructure.GPIO_Speed = GPIO_Speed_100MHz;//100MHz
//  GPIO_InitStructure.GPIO_PuPd = GPIO_PuPd_UP;//上拉
//  GPIO_Init(GPIOB, &GPIO_InitStructure);//初始化
	
	GPIO_PinAFConfig(GPIOB,GPIO_PinSource12,GPIO_AF_SPI2); //PB3复用为 SPI2
	GPIO_PinAFConfig(GPIOB,GPIO_PinSource13,GPIO_AF_SPI2); //PB4复用为 SPI2
	GPIO_PinAFConfig(GPIOB,GPIO_PinSource14,GPIO_AF_SPI2); //PB4复用为 SPI2
	GPIO_PinAFConfig(GPIOB,GPIO_PinSource15,GPIO_AF_SPI2); //PB5复用为 SPI2

 
	//这里只针对SPI口初始化
	RCC_APB2PeriphResetCmd(RCC_APB1Periph_SPI2,ENABLE);//复位SPI1
	RCC_APB2PeriphResetCmd(RCC_APB1Periph_SPI2,DISABLE);//停止复位SPI1

	SPI_InitStructure.SPI_Direction = SPI_Direction_2Lines_FullDuplex;  //设置SPI单向或者双向的数据模式:SPI设置为双线双向全双工
	SPI_InitStructure.SPI_Mode = SPI_Mode_Master;		//设置SPI工作模式:设置为主SPI
	SPI_InitStructure.SPI_DataSize = SPI_DataSize_8b;		//设置SPI的数据大小:SPI发送接收8位帧结构
	SPI_InitStructure.SPI_CPOL = SPI_CPOL_Low;		//串行同步时钟的空闲状态为高电平
	SPI_InitStructure.SPI_CPHA = SPI_CPHA_2Edge;	//串行同步时钟的第二个跳变沿（上升或下降）数据被采样
	SPI_InitStructure.SPI_NSS = SPI_NSS_Hard;		//NSS信号由硬件（NSS管脚）还是软件（使用SSI位）管理:内部NSS信号有SSI位控制
	SPI_InitStructure.SPI_BaudRatePrescaler = SPI_BaudRatePrescaler_256;		//定义波特率预分频的值:波特率预分频值为256
	SPI_InitStructure.SPI_FirstBit = SPI_FirstBit_MSB;	//指定数据传输从MSB位还是LSB位开始:数据传输从MSB位开始
	SPI_InitStructure.SPI_CRCPolynomial = 7;	//CRC值计算的多项式
	SPI_Init(SPI2, &SPI_InitStructure);  //根据SPI_InitStruct中指定的参数初始化外设SPIx寄存器
 
	SPI_Cmd(SPI2, ENABLE); //使能SPI外设

	//SPI2_ReadWriteByte(0xff);//启动传输		 
}   
//SPI1速度设置函数
//SPI速度=fAPB2/2^(SpeedSet+1)
//fAPB2时钟一般为84Mhz
void SPI2_SetSpeed(u8 SPI_BaudRatePrescaler)
{
  assert_param(IS_SPI_BAUDRATE_PRESCALER(SPI_BaudRatePrescaler));//判断有效性
	SPI2->CR1&=0XFFC7;//位3-5清零，用来设置波特率
	SPI2->CR1|=SPI_BaudRatePrescaler;	//设置SPI1速度 
	SPI_Cmd(SPI2,ENABLE); //使能SPI1
} 
//SPI1 读写一个字节
//TxData:要写入的字节
//返回值:读取到的字节
u8 SPI2_ReadWriteByte(u8 TxData)
{		 			 
 
  while (SPI_I2S_GetFlagStatus(SPI2, SPI_I2S_FLAG_TXE) == RESET){}//等待发送区空  
	
	SPI_I2S_SendData(SPI2, TxData); //通过外设SPIx发送一个byte  数据
		
  while (SPI_I2S_GetFlagStatus(SPI2, SPI_I2S_FLAG_RXNE) == RESET){} //等待接收完一个byte  
 
	return SPI_I2S_ReceiveData(SPI2); //返回通过SPIx最近接收的数据	
 		    
}

void SPI2_WriteByte(u8 TxData)
{
	//GPIO_ResetBits(GPIOB,GPIO_Pin_12);
	while (SPI_I2S_GetFlagStatus(SPI2, SPI_I2S_FLAG_TXE) == RESET){}//等待发送区空  
	//GPIO_SetBits(GPIOB,GPIO_Pin_12);
	SPI_I2S_SendData(SPI2, TxData); //通过外设SPIx发送一个byte  数据
		
}
