machunyu/HC8001/Source Code/M0_FirmWare/boot1/m0_i2c_firmware/src/test_uart/driver/i2c1_driver.h

#ifndef _I2C1_DRIVER_H_
#define _I2C1_DRIVER_H_
#include <stdint.h>

extern void i2c1_init(void);
extern void i2c1_wr_data(uint16_t sub_addr,uint16_t wr_dat);
extern uint8_t i2c1_rd_data(uint16_t sub_addr);


#endif
