machunyu/HC8001/(commit log)

2018-07-19 first update
    [v2.0.0R_cfg_reg.xlsx]
2018-07-19 DEMO板用户手册
2018-07-23 最新的串口协议文档
2018-07-25 IIC控制协议文档
