machunyu/HC8001/(notices)

Notices in the files:
Source Code/M4_VIdeoDisplay/Cam_Master_Uart/HARDWARE/DCMI/dcmi.c:
Copyright(C) ¹ãÖÝÊÐÐÇÒíµç×Ó¿Æ¼¼ÓÐÏÞ¹«Ë¾ 2014-2024
All rights reserved
Source Code/M4_VIdeoDisplay/Cam_Master_Spi/SYSTEM/usart/usart.c:
Copyright(C) ¹ãÖÝÊÐÐÇÒíµç×Ó¿Æ¼¼ÓÐÏÞ¹«Ë¾ 2009-2019
